toxonpf/aquaNode/AquaNode_R0.3/README_ru.md

# AquaNode R0.3

Ревизия по инженерному аудиту R0.2, 20 октября 2026. Исправлены механическое размещение, силовая трассировка, сшивка земли, EN стабилизатора, маркировка и представление схемы. Это проверенный комплект CAD для прототипа; физических испытаний ещё нет.

| Пункт аудита | Что сделано |
|---|---|
| Пространство под XIAO | C17/C18 перенесены правее J2; SMD убраны из контура модуля и зоны 4 мм ниже его торца. Контур показан на F.Fab; на F.SilkS — контур с разрывами у шелкографии колодок и USB-C END |
| Силовой узел | Q1/C7/L1/U7/D1/C8/C9/U8 сгруппированы; переключающий узел проложен короткими дорожками; локальный возврат GND 0,8 мм на нижнем слое |
| Ширина питания | Силовые линии 0,6 мм. Единственное сужение питания — 1,5 мм длины / 0,25 мм ширины непосредственно у U1.8 с шагом выводов 0,5 мм |
| Земля | 71 сквозное GND via 0,6/0,3 мм, приоритетные переходы у компонентов и распределённая сшивка двух заливок |
| EN U8 | Вывод 3 подключён к BOOST_IN, вместе с EN U7 |
| Два AFE | Таблица сборок A: 49,9k/49,9k; B: 10k/DNP. Текущий CAD показывает A |
| Импеданс ADS1115 | Расчёт остаточной ошибки и RC, задержка батарейного измерения 600 мс; утверждение о полном подавлении ошибки не делается |
| Подписи | Полярность и назначение контактов разъёмов, маркер K, ориентация XIAO и предупреждение B2B |
| Схема | Стандартные символы KiCad R/C/L/Schottky/PMOS/NMOS; пять функциональных областей |

Открывать `cad/AquaNode.kicad_pro`. Быстрый просмотр: `Report.html`, `Schematic.pdf`, `PCB.png` (оба слоя), `PCB_F.png`, `PCB_B.png`, `Assembly.png`. Нижний слой изображён в координатах вида сверху, без зеркального отражения. Контакты и монтаж сверять по `BOM_ru.md`, `Netlist_ru.md` и `Engineering_ru.md`.

**SKU 102010611: Wio-SX1262 стыкуется с XIAO ESP32S3 только через штатный B2B. Запрещено соединять сквозной пайкой левый ряд Wio с D0–D5 XIAO.** Проверить фактическую ревизию, высоту колодок, вывод BAT-проводов и доступ USB. Печатный контур не заменяет примерку купленных модулей.

Сырые ERC/DRC и геометрическая сверка — `checks/`. Gerber и Excellon — `fabrication_review/`. Проверки САПР не подтверждают пульсации питания, точность pH, работоспособность mesh или герметичность. Перед эксплуатацией выполнить протоколы `Purchase_and_test_ru.md`; для батарейного канала действует уточнённая задержка из `Analog_calculations_ru.md`.

Требования MIT и инструменты журналирования сохранены. Ничего не куплено и не измерено; стадия физического Prototype по-прежнему не подтверждена. Нативный Altium-проект не создавался; предоставлен редактируемый KiCad-проект.
