toxonpf/aquaNode/AquaNode_R0.3_EC_revB/engineering/Audit_ru.md

# Аудит и инженерные решения
## Что найдено и исправлено
1. Номинальные 3,3 В совпадали с нижней границей SEN0244. Даже отрицательный допуск 1% дал бы 3,267 В, без учёта провода и просадки. Перенесено питание M1 на существующие 5V_PH/TP5; J7.2 исключён из кабеля, медь 3V3 не изменена. Схема и design.json описывают тот же жгут.
2. C19 был перед R4, а рекомендация Espressif относится к конденсатору непосредственно у ADC. Перенесён на EC_ADC. С R21+R4 номинальное RC ≈110 мкс и частота среза ≈1,45 кГц, без учёта выходного сопротивления SEN0244. Это не фильтр медленных температурных ошибок и не доказательство точности.
3. PCB сохраняла DS18B20/DQ возле J7. Заменено на EC IN/EC; ревизия обновлена. Маркировка 3V3 возле J7.2 сохранена, поскольку медь остаётся 3V3. Сборщик обязан удалить именно кабельный контакт.
4. Старые BOM, netlist-документ, README, PDF, HTML и верификация противоречили новой сборке. Перенесены в history_ec_revA; текущие инструкции заменены. Полный BOM генерируется из design.json.
5. PH_EN=0 в прежнем скетче несовместим с новым источником EC. Теперь общий узел включается GPIO2 HIGH после настройки GPIO. J9 при EC-тестах отключён целиком. Включение питания pH не означает, что реализовано измерение pH.
6. Добавлены запрет сборки для неподходящего MCU/без USB CDC, повторный поиск DS18B20 после ошибки, флаг допуска питания и ограничение выдачи EC при непроверенной температурной компенсации. По умолчанию численное EC не выдаётся.
7. Идентификатор калибровки ограничен безопасными символами при генерации; значения из синтетических тестов не попадают в calibration.h.

## Питание: расчёт, не испытание
SEN0244: питание 3,3–5,5 В, выход 0–2,3 В, ток 3–6 мА. TPS7A2050 при применимости паспортных условий: 5 В ±1,5%, то есть 4,925–5,075 В. Статический запас до нижней границы SEN0244 — 1,625 В, до верхней — 0,425 В. Результат требует измерения выбросов/просадки и запуска, а не только мультиметра.

U7: R7=69,8 кОм, R8=20 кОм, оба 0,1%; Vref 1,208–1,258 В. Идеальный диапазон задания BOOST_RAW от ≈5,415 до ≈5,657 В. Это не полная граница: FB bias, load regulation, пульсации, запуск и монтаж добавляют ошибку. Рабочий вход U8 максимум 6,0 В: отсутствие выбросов выше него — блокирующая проверка. Нельзя принимать 400 мА ограничения ключа TPS61040 за доступный выходной ток 5 В. Питание всего узла идёт через XIAO 3V3, его свободный ток ещё не установлен.

SEN0244 при 5 В потребляет по паспортному току 15–30 мВт; это 0,36–0,72 Вт·ч/сутки на выходе 5 В при непрерывном питании. При условном совокупном КПД 80% — 0,45–0,90 Вт·ч/сутки от источника, без MCU и радио. Это иллюстрация, не измеренный бюджет автономности. Стенд не использует deep sleep. Экономию циклическим питанием можно заявить только после определения времени стабилизации.

## ADC и бюджет
DFRobot рекомендует ADS1115 для ESP32 (FAQ Q5). Встроенный ESP32-S3 ADC оставлен только для квалификационного стенда: он не требует нового компонента, диапазон 11 dB охватывает выход SEN0244, analogReadMilliVolts применяет калибровку напряжения, медиана подавляет часть помех. Это не доказательство достаточной линейности.

Предпочтительный путь следующей PCB при провале ADC-теста — использовать уже имеющийся ADS1115, освободив AIN2 от GND и выполнив новую трассировку/проверки. Дополнительная микросхема тогда не нужна, но требуется новая плата и прошивка. В этой ревизии такого изменения НЕТ. Паять EC к существующему AIN2/AIN3 нельзя. Второй модуль ADC добавляет стоимость без необходимости до результатов сравнительного теста.

## Открытые блокеры
| ID | Проблема | Условие закрытия |
|---|---|---|
| B01 | Нет native ERC/DRC revB, экспорта схемы и CAM-проверки | Запустить KiCad, разобрать все ошибки, экспортировать заново |
| B02 | ESP32 прошивка не скомпилирована | Успешная сборка реальным ESP32 toolchain, затем загрузка и USB-тест |
| B03 | Питание и shutdown transients | Осциллограммы по плану, без выхода за паспортные пределы |
| B04 | EC/ADC, температурная модель | Независимые стандарты, sweep напряжения, температурные точки |
| B05 | Взаимовлияние EC/pH | Сравнение раздельно/вместе; изоляция или документированный иной метод при провале |
| B06 | pH AFE не закреплён конкретным проверенным MPN | Подтвердить питание, выход, ток, прогрев; выбрать сборку делителя |
| B07 | Механика, герметичность, обрастание | Посадка XIAO/Wio, внешняя сборка и реальные водные испытания |
| B08 | Радио/mesh, частоты и регион | Отдельная прошивка, полевой тест, проверка местных требований перед TX |
| B09 | Батарея и зарядка | Конкретная защищённая 1S батарея, полярность, допустимые токи/температуры |

Старые документы ссылались на тайваньский радиоплан. Он не является настройкой для Казахстана или Гавайев. revB ничего не передаёт; конкретные радиопараметры не утверждены.

Полный просмотр состава включает декодирование файлов, структуры CAD/JSON, чтение текстовых материалов и PDF. Это не функциональная верификация каждой цепи или полная проверка всех footprint по даташитам. Список входных файлов и хешей — checks/input_inventory.json. Исходные лицензии и атрибуция сохранены.
