toxonpf/aquaNode/public/resources/ec-ph-revc/copy_zh-TW.md

# AquaNode R0.3-EC-pH-revC

## 文件範圍

本文件僅適用於 2026 年 11 月 2 日開發中的 R0.3-EC-pH-revC 測試台版本。團隊表示 AquaNode 已有裝置、經檢查感測器的量測與寄送給夥伴的浮標。這些裝置紀錄與下列 revC 檢查分開。

版本日期：2026 年 11 月 2 日。淡水環境教育平台配置；硬體驗證尚待完成。

## 目前配置

- XIAO ESP32S3 協調平台原始碼與 USB 記錄。
- SEN0244 是研究中的 TDS 模組，用於淡水實驗性 EC 估算；它不能辨識個別鹽類，也非海水鹽度儀。
- DS18B20 提供溫度輸入。
- SEN0169-V2 加入 pH 電極與轉換板。DFR0504 在 ADS1115 擷取前隔離其電源與類比訊號。
- pH 隔離器需要獨立穩壓平台電源：5.00 ±0.10 V、至少 0.5 A。電池供電 pH 仍需選定獨立轉換器並更新能耗預算。

## 校正與共同運作

此設計允許 pH 電極與 EC 留在同一水樣。隔離不證明干擾已消除。必須以真實緩衝液校正完整的電極–轉換板–隔離器–分壓器–ADC 鏈路，驗證電源，並分別與共同測試感測器。

原始碼讀取分壓器之後的 pH ADC 電壓。在真實校正與驗證放行之前，數值 pH 預設為 null；目前未提供真實 pH 或 EC 係數。數值 pH 限於已量測的校正範圍及校正溫度 ±0.5 °C，未宣稱自動 pH 溫度補償。手動放行旗標不是即時保護機制。

## 佐證與後續工作

套件報告記錄 18 項 Python 測試通過：15 項 EC 模型與 3 項 pH 匯出器測試。原始檔比對涵蓋 166 個原理圖接腳與 139 個編號 PCB 焊墊；銅箔及焊墊位置沿用 revB。這些檢查不驗證實體接線、感測準確度或 KiCad 設計規則。

ESP32 建置在下載相依套件時中斷。另有 15 項 C++ pH 斷言已準備但未執行。原生 ERC/DRC、裝置執行、真實校正、同一水樣測試、外殼與電池驗證仍待完成。目前沒有新的製造發行、revC 實測準確度、已驗證的無線電／網狀網路或實地部署佐證。

簡報設定檔明確標示為 simulation，範例讀值是虛構的；它與工程結果分開，硬體韌體不載入此設定檔。網站的台灣站點檔案是獨立來源，並非 AquaNode 量測。

公開網頁資料包含概覽、衍生狀態快照、佐證筆記與架構示意；不取代完整工程說明，也不公開韌體或協定實作。文件與網站衍生圖採 CC BY 4.0，保留原始出處。
