toxonpf/aquaNode/AquaNode_R0.3_EC_revB/history_ec_revA/Report.html

# AquaNode R0.3-EC

Бюджетная экспериментальная оценка проводимости пресной воды. Основа R0.3; SHT40 отсутствует.

R3 снять. J7 теперь EC. DS18B20 перенесён на D6/GPIO43. Старые прошивка и маркировка разъёма несовместимы с новой сборкой.

- Сборочная схема PDF · KiCad
- Подключение и ограничения
- Стоимость добавления
- Калибровка и приёмка
- Стендовый код
- Проверки

Проверенная цена SEN0244 $11.80. Ориентир электроники канала $13.80–16.80; стандарты, доставка и сборка отдельно. EC является оценкой, не паспортным измерением. Морская вода не поддерживается.

Новый ERC/DRC, компиляция ESP32 и физические испытания ещё не выполнены. Материалы исходного носителя — в baseline_r03.
