toxonpf/aquaNode/AquaNode_R0.3_EC_pH_revC/README_ru.md

# AquaNode R0.3 EC + pH revC

Обновлено 02.11.2026 по запросу: включить pH, выбрать конкретный комплект и повторно сверить подключения. В revC pH-электрод остаётся подключённым и может находиться в той же воде, что EC, через добавленную гальваническую развязку. Совместные измерения требуют стендовой приёмки.

Выбран **DFRobot SEN0169-V2**, комплект промышленного pH-электрода и платы преобразования с BNC. Между ним и AquaNode добавлен **DFRobot DFR0504**: развязка питания и аналогового сигнала. Температура — DS18B20, экспериментальная оценка EC — SEN0244, контроллер — XIAO ESP32S3, pH считывает установленный ADS1115.

**Это обновлённая стендовая конфигурация. Автономная работа pH от аккумулятора не завершена:** для DFR0504 используется внешний лабораторный источник 5,00 ±0,10 В, не менее 0,5 А. Ранее существовавший boost/LDO питает только EC; его токовый запас не подтверждён для добавленной нагрузки. Для батарейного буя нужен отдельный выбор и проверка преобразователя и обновлённый энергобюджет.

## Что изменено

- В KiCad-схему и `design.json` добавлены SEN0169-V2, DFR0504 и источник стендового питания.
- Обновлены BOM, подключения и пометки на плате. Геометрия меди и расположение площадок несущей платы сохранены.
- J9 подключён к стороне **MCU** DFR0504: контакт 1 — общая земля, контакт 3 — выход A. Контакт 2 исключён из кабеля. Перемычка JP1 снята.
- pH-модуль подключён только к изолированной стороне **SEN** DFR0504; её землю не соединять с землёй AquaNode.
- Прошивка `firmware/ec_ph_bench` считывает AIN0 ADS1115 по I²C GPIO5/GPIO6, адрес 0x48, и выдаёт `ph_adc_mv`, `ph`, `ph_status` через USB вместе с EC и температурой.
- Показания в милливольтах доступны сразу после начальной паузы; численное pH требует реальной калибровки всей цепи, проверки питания и совместной работы датчиков. Заводские или вымышленные коэффициенты не подставлены.

## Что читать

1. `engineering/Connection_review_ru.md` — выбор модели, результаты сверки и ограничения.
2. `engineering/Pinout_ru.md` — точная таблица сборки; актуальна вместо revB.
3. `bench/Plan_ru.md` — питание, калибровка и испытания обоих электродов в одной воде.
4. `firmware/README_ru.md` — сборка и формат данных.
5. `checks/` — фактические отчёты проверок этой поставки.

Исходный revB сохранён целиком в `history/original_revB.zip`. Его инструкции об отключении pH относятся к старой конфигурации. Старые Gerber/PDF внутри исторического ZIP не являются производственными файлами revC.

Новые Gerber не выпущены. Без native ERC/DRC, аппаратной проверки питания и испытаний в воде этот пакет не считать готовым к производству или подтверждением точности всего устройства.
