toxonpf/aquaNode/AquaNode_R0.3_EC_revB/history_ec_revA/MIT_requirements_ru.md

> **R0.3-EC, 29.10.2026:** исходный текст R0.3 ниже является базовой документацией. Для текущей сборки приоритет имеют EC_integration_ru.md и EC_BOM_ru.md: R3 отсутствует; J7 используется для EC; DS18B20 перенесён на D6/GPIO43. Старые ERC/DRC и Gerber находятся в baseline_r03 и не подтверждают новую сборку.

# Соответствие требованиям и доказательства

Статус на 20 октября 2026: по сообщению владельца ничего не куплено. Есть проект электроники, но нет физического прототипа, прошивки и результатов измерений. Нельзя выбирать стадию Prototype только на основании CAD-файлов.

Документ пользователя использован как план подготовки. Его рекомендации не превращены в обязательные правила MIT. Упоминание ESP8266/мутности в нём не заменяет исходное ТЗ: здесь ESP32S3, температура, pH и батарея; датчиков мутности и кислорода нет.

| Требование / рекомендация | Что подготовлено | Что ещё необходимо | Доказательство |
|---|---|---|---|
| Функционирующая первоначальная версия — критерий стадии Prototype | Трассированная плата, BOM, проверки CAD | Купить, собрать, написать и проверить прошивку | Непрерывное видео работающей цепочки |
| Реальные параметры воды | DS18B20 и вход pH AFE предусмотрены | Калибровка и сравнение с эталоном | Исходные коды АЦП, температуры, условия, коэффициенты |
| Передача и сохранение | Интерфейс SX1262, формат журналов и инструменты записи | Реализовать связь, собрать передатчик и приёмник | Два независимых журнала TX/RX с идентификаторами |
| Mesh, если заявляется | Распиновка не препятствует реализации | Третий узел, маршрутизация, проверка ретрансляции | Приём при заблокированном прямом пути, маршрут и TTL |
| Работа в воде — сильное подтверждение | Протокол подготовлен | Корпус, гермовводы, поплавок, испытания | Фото, время, масса до/после, состояние внутри |
| Повторяемость и автономность | Методика и формула энергобюджета | Измерить режимы и длительность работы | Осциллограммы/журнал тока, полный профиль, отказы |
| Стоимость и воспроизводимость | MPN носителя и перечень покупок | Фактические цены, доставка, ревизии | Чеки/счета, итоговая BOM собранного экземпляра |
| Климатическая польза | Проверяемая гипотеза ниже | Подтвердить проблему и действия оператора | Интервью, пилот, заранее выбранная метрика |
| Внешнее признание/YIC | Ничего не подтверждено | Только реальные документы при наличии | Публичная ссылка или документ организатора |

Количество пакетов, длительность теста и пороги точности ниже — внутренние цели разработки, а не требования MIT. Пример «97 из 100» из приложенного документа не является результатом AquaNode и не включён в доказательства.

## Практический маршрут

Сначала собрать два модульных узла на столе: один измеряет температуру, второй сохраняет принятые данные через USB на ноутбук. Собственная PCB не обязательна для этого первого доказательства. После устойчивой связи добавить pH, затем корпус и короткий водный тест. Заявлять ровно то, что удалось воспроизвести: один радиоканал не называть mesh, краткий тест не называть многомесячной автономностью.

Если до подачи нет работающего экземпляра, электронный проект остаётся стадией концепции. Обещание будущей сборки не заменяет выполнение критерия Prototype. Эта ревизия повышает готовность к сборке, но сама по себе не закрывает условия участия.

## Проверяемая гипотеза пользы

Рабочая гипотеза: оператор рыбоводного хозяйства использует сообщения о температуре и pH, чтобы вовремя проверить водоём и принять заранее согласованное действие. Для пилота нужно назвать конкретного оператора, сравнить время обнаружения отклонений с ручными обходами и фиксировать последующие действия. Снижение потерь рыбы, расхода энергии или выбросов пока не измерено. Температура и pH не измеряют растворённый кислород; не делать выводов о его концентрации и не запускать автоматическое управление аэрацией только по этим двум показателям.

## Комплект доказательств после испытаний

Хранить вместе: идентификатор экземпляра и ревизии; фото соединений; версии прошивки; исходные TX/RX журналы; калибровку и эталон; условия/место/дату; видео; таблицу отказов; фактическую BOM; краткий отчёт с ограничениями. Не редактировать исходные журналы для удаления неудачных измерений — помечать исключения отдельно. Публиковать только данные с разрешением владельца площадки.

В разделе заявки о сделанном описывать только завершённые работы; план выделять отдельно. Сейчас допустимая формулировка: «Разработана и проверена средствами KiCad схема и трассировка носителя. Закупка, прошивка и физические испытания ещё не выполнены». После теста заменить её фактическими числами с условиями и ссылками, не заранее заполненным успехом.

## Официальные источники и сроки

[MIT Solve Global Climate Challenge](https://solve.mit.edu/challenges/2027-global-climate-challenge?tab=faq) описывает стадии и критерии. [Официальная анкета 2027](https://5593819.fs1.hubspotusercontent-na1.net/hubfs/5593819/2027%20Global%20Challenges_%20Application%20Questions.pdf) просит объяснить выбранную стадию и уже выполненные работы. На проверенной странице указан срок 6 ноября 2026, 12:00 EST; в PDF анкеты — 2 ноября. Для внутренней подготовки использовать более раннюю дату, окончательный срок сверить в действующем портале перед подачей. Наличие всех рекомендуемых доказательств не гарантирует отбор.

## Как описывать EC в заявке

«Разработана бюджетная экспериментальная интеграция проводимости для пресной воды; аппаратная калибровка и полевые испытания запланированы». После испытаний заменить фактическими цифрами. Не писать о морской солёности, лабораторной точности или работающем канале только на основании CAD и программных тестов.
