toxonpf/aquaNode/docs/editorial-audit-2026-11-04.md

# Редактура AquaNode — 4 ноября 2026

Основание: задание владельца от 3 ноября и уточнение 4 ноября: разрешены расчётные примеры на основе региональных измерений с отклонением до 5%. Работа выполнена в исходниках, без публикации сайта.

## Что изменено

- Главная: факты об измерениях и отправке устройств, прямые ссылки на карту и устройство. Удалены общая плашка revC, повторный рассказ о трёх частях буя, декоративный переход «почему вода», пять абзацев учебного цикла, повторные заголовки документации и команды.
- О проекте: три учебных действия «Собрать / Измерить / Обсудить результаты». Удалены общая плашка ревизии, неподтверждённые цели 10 / 500+ / 50+ км, повторная миссия и слоганы. Сохранены сертификат YIC 2026 и GEEP.
- Устройство: существующие устройства описаны перед отдельной revC. Сохранены SEN0244, DS18B20, SEN0169-V2, DFR0504, ADS1115, отдельное питание pH и температурное ограничение. Проверки кода не переименованы в аппаратные испытания. Компоновка 3D остаётся иллюстративной.
- Build: выбор актуальных обзорных документов revC либо архивных материалов платы R0.3. Сохранены семь раскрывающихся задач разработки и якоря; удалены повторные «перед следующим шагом» и описание самого интерфейса. Файлы не называются полным комплектом изготовления или прошивкой.
- Журнал: удалены декоративная обложка и повторные объяснения чтения. Добавлена недатированная заметка команды об устройствах и сотрудничестве. Датированные проверки revC от 2 ноября и R0.3 от 20 октября сохранены; исходные результаты не изменены.
- Команда: сохранены имена, роли и контакты, удалены повторные общие биографии и слоганы. Для сотрудничества используется уже опубликованный Telegram основателя.
- Метаданные: отдельные title / description / OG для всех семи маршрутов, начальный HTML согласован с русской главной.
- RU / EN / zh-TW: новые тексты и доступные подписи сведены в `editorial-ru.json` / `editorial-zh.json`; английский остаётся источником строк. Обзоры revC и генератор схем также уточняют область применения.

## Привязка фактов к источникам

| Объект | Что известно | Что показано |
| --- | --- | --- |
| Существующие AquaNode | Владелец подтвердил устройства, проверку датчиков, данные и отправку партнёрам | Сообщение команды; без выдуманных ID, дат, точности и количества |
| География сотрудничества | Актау, Гавайи, Тайвань из задания и прежних материалов | Три региональные отметки. Это не три устройства и не установленная сеть |
| revC | Пакет 2 ноября 2026, состав и отчёты в `AquaNode_R0.3_EC_pH_revC` | Собственная конфигурация и статус разработки |
| R0.3 | Прежняя плата, отчёт 20 октября, чертёж / BOM | Отдельный архив документов и запись журнала |
| Станции Тайваня | `stations_data_en.csv`, 388 записей, четыре станции, 2002–2026 | Исходные даты, числовые значения, пропуски и пределы обнаружения; CSV для скачивания |
| Расчётные примеры | Получены программно из выбранной записи станции | Привязаны к 104 исходным отметкам; источники — региональные публикации и архив станций. Исходное и расчётное значения, отклонение до 5% видны рядом |

## Карта и данные

После уточнения владельца восстановлены все 104 исходные отметки (97 Актау, 3 Гавайи, 4 Тайвань), с прежними ID и позициями. Счётчик обозначает отметки карты; координаты остаются приблизительными. Четыре референсные станции сохранены отдельным отключаемым слоем.

Каждому бую назначены явно подписанные расчётные показания, полученные из опубликованных региональных наблюдений с отклонением не более 5%. Для Актау используется pH 8.12 из пробы K4 от 13.09.2023; для Гавайев — региональные средние у Мауи (26.3 °C, pH 8.17), с явной оговоркой о географии; для Тайваня — соответствующая запись станции из CSV. Даты и пропуски источника сохранены. Все 104 записи доступны в JSON с признаком `calculation-example`. Метод, ссылки и ограничения описаны в [observation-map.md](observation-map.md).

## Что ещё нужно от команды

- Исходные измерения самих буёв AquaNode: устройство/версия, параметр и единица, время с часовым поясом, место, файл или API.
- Подтверждённый список устройств и дат отправки / доставки / установки. Общий факт отправки не использован как доказательство установки или текущей передачи.
- Состав фактически проверенных сборок и записи их калибровки. Состав revC не перенесён на эти устройства.
- Публичные имена партнёров и разрешённые сведения о сотрудничестве, если требуется назвать организации.

Поэтому реальные измерения **AquaNode** не опубликованы как числовые карточки: их файлов не предоставили. Публикуются реальные записи **сторонних станций** и отдельно отмеченные расчётные примеры. Пустые измерительные шаблоны из инженерного пакета не использованы как результаты.

## Проверка

Выполнены целевые браузерные проверки всех семи маршрутов на RU / EN / zh-TW при 1440, 390 и 320 px (63 сочетания), а также проверки оборудования и документации на дополнительных размерах 768–1920 px.

41 целевой тест прошёл в соответствующих группах Playwright: `pages/editorial`, `pages/about`, `pages/build`, `pages/journal`, `pages/map`, `pages/technology`, `pages/revc-content`, `pages/home-features`, `ui/content-integrity`, `ui/map-embeds-mobile`, `team/team-flow`. Проверены метаданные, якоря, раскрытие, управление с клавиатуры, датчики, оригинальные даты и пропуски CSV, граница 5%, загрузки и неизменность статуса revC. Тесты выполнялись с `PLAYWRIGHT_CHROMIUM_EXECUTABLE_PATH=/usr/bin/chromium`; проверка карты также включает недоступность внешней подложки.

`npm run build` и `git diff --check` проходят. Просмотрены снимки компьютера и телефона, включая RU / zh-TW и расчётную карточку EN / RU. Это целевой набор для редактуры, не полный исторический набор всех UI-тестов репозитория. Физические испытания этой редактурой не выполнялись.

## Уточнения дизайна и восстановление карты

После обратной связи владельца:

- Разнесены кнопки в океанском блоке «Что такое AquaNode». Удалены градиентные маски, затемнявшие верхние подписи четырёх глав.
- Большие пустые завершения страниц заменены компактными парными переходами. Контактный блок команды также уплотнён, без изменения геометрии профилей.
- Дополнены заголовок результатов и блок `#why` на главной; добавлена последовательность из трёх этапов наблюдения.
- В первый экран журнала добавлены последние записи с рабочими якорями и фактическими метриками проверок.
- Блок существующих устройств дополнен архивной схемой с подписью версии и перечнем результатов команды; intro оборудования Build оформлен как подготовка рабочего места.
- Восстановлены 104 исходных маркера с прежними ID и позициями, добавлены расчётные записи и JSON-выгрузка. Метод и источники — в `observation-map.md`.

Итоговые целевые проверки охватывают 40 различных тестов Playwright: `editorial`, `layout-restoration`, `map`, `map-embeds-mobile`, `about`, `build`, `home-features`, `journal`, `technology`, `content-integrity`, `team-flow`. Проверены три языка, ширины 320–1920 px, раскрытия и якоря, отсутствие переполнения, геометрия карточек команды, исходные даты/пропуски и предел генерации 5%. Найденная мелкая подпись схемы исправлена; повторная проверка минимальных размеров прошла. Просмотрены скриншоты новых блоков, океанских подписей и карточек данных. Финальные `npm run build` и `git diff --check` проходят.
