toxonpf/aquaNode/docs/team-contacts.md

# Фотографии и контакты команды

Данные находятся в `src/data/catalog.ts`, массив `team`. Разметка страницы — в `src/pages/team/TeamRoster.tsx`. Карточка, модальный портрет и миниатюра используют единый компонент `src/pages/team/TeamPortrait.tsx`: одинаковые фото, тонировку, волны, подпись и инициалы.

Участники показаны в портретной галерее. Нажатие на портрет открывает профиль с крупной фотографией и теми же контактами. Внутри профиля доступны переключение участников, закрытие кнопкой и Escape. На телефоне все ссылки видны без наведения.

Колонки галереи имеют независимый вертикальный ритм: следующий портрет начинается до окончания предыдущего. На телефоне продолжение дополнительно обозначено миниатюрой следующего участника. При прокрутке портреты раскрываются диагональной шторкой. При открытии профиля изображение сначала останавливается в центре экрана, затем сдвигается вместе с раскрытием панели информации. При переключении людей панель убирается, портрет возвращается в центр, сменяется следующим и снова раскрывается. Карточки в галерее плавно меняют прозрачность; выбранная остаётся скрытой до завершения возврата изображения при закрытии окна. Настройка уменьшения движения отключает эти анимации.

Первыми показаны Timur Kuandykov и Roman Benzler. Для Кирилла подключены Telegram, GitHub и LinkedIn; для Романа и Тимура — LinkedIn и Telegram; для Аяна — Instagram, Spotify, LinkedIn и Telegram. Адреса предоставлены командой. У Артура контакты пока не заполнены. Значение `url: null` остаётся поддержанным вариантом некликабельной заготовки.

Чтобы подключить несколько контактов одному человеку, замените его запись, например так (адреса ниже демонстрационные, их нужно заменить):

```ts
{
  slug: 'kirill-dubinin',
  name: 'Kirill Dubinin',
  role: 'Engineering & outreach',
  photo: '/assets/team/kirill-dubinin-portrait.webp',
  links: [
    {kind: 'email', label: 'Email', url: 'mailto:your-address@example.com'},
    {kind: 'telegram', label: 'Telegram', url: 'https://t.me/YOUR_HANDLE'},
    {kind: 'github', label: 'GitHub', url: 'https://github.com/YOUR_HANDLE'},
    {kind: 'website', label: 'Website', url: 'https://example.com'},
  ],
}
```

Можно добавить любое количество элементов в `links`. Для двух контактов одного вида задайте разные `label`, например «Рабочая почта» и «Личная почта». Поддерживаются `email`, `telegram`, `github`, `website`, `linkedin`, `instagram`, `spotify`. Внешние веб-ссылки открываются в новой вкладке; `mailto:` и `tel:` обрабатываются браузером обычным образом.

Фотографии положите в `public/assets/team/` в формате WebP. Поле `profilePhoto` задаёт фотографию внутри раскрытого профиля; поле `photo` — в карточке галереи и миниатюрах. Для Тимура, Романа и Аяна подключены оба поля: используются ранее присланные фотографии, с волнами поверх карточек. Имена файлов имеют вид `имя-фамилия-portrait.webp`. Исходные JPEG/PNG хранятся в `assets-source/team/` и не попадают в сайт. Значение `null` оставляет графический портрет с инициалами.

Сертификат GEEP размещён в `public/resources/awards/geep-yic-2026-winner.png`, его оптимизированное превью — в `public/assets/awards/geep-yic-2026-winner.webp`. Пути находятся в `awardCertificate` в каталоге контента. Сценарий `scripts/prepare-site-images.mjs` локально преобразует исходные изображения и переносит их из корня; существующие файлы не перезаписывает.
