toxonpf/aquaNode/AquaNode_R0.3_EC_pH_revC/bench/Plan_ru.md

# Стендовая приёмка revC: pH + EC + температура

Это план, результаты ещё не получены. Численные цели ниже — критерии для испытаний, а не достигнутые характеристики. Сохранять дату, исполнителя, прибор/погрешность, фото жгута, SHA256 прошивки и калибровки, сырой USB-лог и pass/fail. Независимый контрольный раствор не использовать для подбора коэффициентов.

## 1. До подачи питания

Проверить `engineering/Pinout_ru.md` по каждому соединению. R3 отсутствует; J7.2 и J9.2 без кабельных контактов; JP1 открыт; C19 после R4. Плата SEN0169-V2 соединена только с SEN стороной DFR0504. Основная земля и изолированная земля не соединены через крепёж, кабель, термощуп или приборы. Вода будет связывать электроды электрохимически, поэтому проверку отсутствия металлического обхода проводить до погружения. Проверить полярность батареи, механическую посадку XIAO/Wio и отсутствие чужих перемычек.

Native KiCad ERC/DRC должны быть выполнены и разобраны до изготовления PCB. Исходниковая сверка в пакете их не заменяет. Первый запуск допускается на отдельно проверенном макете с ограничением тока, не как подтверждение исходной PCB.

## 2. Питание

Проверить EC узел без SEN0244 с нагрузкой 1 кОм, затем 820 Ом. Проверить 5V_PH и BOOST_RAW при USB и выбранных режимах батареи. Установившееся 5V_PH — целевые 4,85–5,15 В; питание SEN0244 при работе в паспортных пределах 3,3–5,5 В, BOOST_RAW не выше рабочего максимума U8 6,0 В, включая выбросы с учётом погрешности. Затем повторить с SEN0244, измерить ток и запуск.

Для M4 отдельный PS1: **5,00 ±0,10 В на входе MCU** под реальной нагрузкой, включая пуск и переходы. Проверить изолированный SEN выход 4,8–5,2 В, ток pH-модуля <170 мА с запасом и суммарный ток первичной стороны. Внешний источник ≥0,5 А выбран как стендовый запас, а не измеренное потребление. TP5 не использовать для питания M4.

Включать AquaNode первым, внешний PS1 последним; выключать в обратном порядке. Осциллографом проверить PH_OUT, ADC_PH, 3V3 и EC_ADC при включении/выключении, минимум 20 циклов. Во время работы входы ADC остаются между GND и VDD; при отключении не превышают абсолютные пределы из даташитов и не поддерживают выключенную 3V3 подпиткой. На изолированной стороне использовать дифференциальный/изолированный пробник; обычной землёй осциллографа нельзя закорачивать барьер. До автоматического полевого применения нужна аппаратная блокировка неверного порядка питания.

Только после этого выставлять `SUPPLY_VALIDATED` для EC и `PH_SUPPLY_VALIDATED` для pH. Это ручные отметки принятия конкретной сборки, а не динамическая защита.

## 3. ADC и температура

EC: отключить выход SEN0244, подать точные 0,15/0,25/0,5/1/1,5/2/2,3 В через R21/R4; ≥100 отсчётов на уровень. Предварительная цель ошибки: ≤max(10 мВ, 1%), разброс P90−P10 ≤10 мВ. Порог 40 мВ прошивки — только грубая отбраковка.

pH: сначала проверить ADS1115 AIN0 введением напряжений на PH_OUT через штатный делитель (изолятор A отсоединён). Затем отдельно проверить всю цепь M4 от SEN A до AIN0. Дать время на 4-секундное типичное обновление изолятора и фильтры; подтвердить реальное время установления. Сравнить с независимым вольтметром, проверить монотонность, коэффициент передачи и дрейф. Проверка AIN0 без изолятора не подтверждает весь канал.

DS18B20: проверить в точках 10/25/35 °C с эталонным термометром, отключение и восстановление. При отсутствии корректной температуры численное pH/EC не выдаётся. Не принимать 85 °C после старта или −127 °C ошибки за воду.

## 4. pH-калибровка всей цепи

Электрод подготовить по руководству производителя, держать плату и BNC сухими. Применить свежие буферы с известным pH при фактической температуре. Калибровать всю цепь: электрод → M3 → M4 → R9/R10 → ADS1115. Записывать **`ph_adc_mv` после делителя**, не напряжение электрода и не удвоенные милливольты. Значение pH буфера брать из его температурной таблицы.

Производитель использует pH 4 и 7. Для щелочной воды нужны точки, охватывающие ожидаемый диапазон, например 7 и 10, и независимая проверка внутри диапазона. Прошивка допускает две реальные точки с разницей ≥2 pH и убывающим напряжением; численное pH за пределами калибровки не экстраполирует. При необходимости широкого диапазона дополнительно оценить линейность по нескольким стандартам.

Для каждой точки дождаться устойчивости, сохранить ≥20 показаний, среднее/медиану и температуру. Создать JSON с `cal_id`, `adc_mv_low`, `ph_low`, `adc_mv_high`, `ph_high`, `temperature_c`; low/high относятся к **pH**, поэтому mv_low > mv_high. Генератор `test_tools/export_ph_calibration.py` создаёт заголовок, затем его надо поставить в прошивку и пересобрать. Не применять синтетические тестовые данные.

Пока температурная модель не исследована, pH выдаётся лишь в пределах **±0,5 °C от температуры калибровки**. Температурная поправка буферов и компенсация чувствительности электрода — разные задачи; автоматическая компенсация не заявляется.

Независимая проверка: предварительная цель всей цепи ≤0,2 pH в выбранном диапазоне при температуре калибровки. При провале раздельно проверить изолятор и AFE; ±0,1 pH из паспорта датчика не является гарантией AquaNode.

## 5. EC-калибровка и совместная работа

EC калибровать по `test_tools/ec_model.py` двумя стандартами и проверить третьим независимым. SEN0244 остаётся TDS-модулем с экспериментальной оценкой EC. Проверить нелинейность ADC и температурную поправку; без её допуска EC ограничен 25 ±0,5 °C. Сохранить старый EC-план из `history/original_revB.zip` только как справочный материал; старое требование убрать pH не относится к совместному тесту revC.

Сравнить в одном образце при неизменной температуре: pH отдельно; EC отдельно; оба подключены и включены; EC выключен; PS1 выключен при всё ещё включённом MCU. Удаление/добавление электрода тоже фиксировать, не менять одновременно состав воды. Повторить с разными проводимостями и расстоянием между пробами, минимум 3 повторения.

Предварительная цель влияния: изменение pH ≤0,05 и EC ≤max(20 мкСм/см, 2%). Если разброс методов не позволяет различить такой сдвиг, результат неопределённый, а не PASS. При провале выяснить обход изоляции, питание и помехи, затем повторить. **`PH_COEXISTENCE_VALIDATED=true` выставлять только после прохождения этого теста**. При замене датчика, источника, жгута или схемы снять допуски и повторить проверку.

## 6. После допуска

24-часовой лог с обоими электродами, контрольные растворы до/после, дрейф, перезапуски, энергопотребление. Затем испытания корпуса и обрастания в воде. Числа автономности выводить из измеренного энергопрофиля и выбранной батареи. Радио/mesh остаются отдельной задачей: текущая прошивка работает через USB.
