toxonpf/aquaNode/AquaNode_R0.3_EC_pH_revC/engineering/Budget_options_ru.md

# Почему добавление pH стоит $84,80

Цены проверены 02.11.2026 на страницах производителя, без доставки и налогов.

| Вариант | Комплектация | Сумма |
|---|---|---:|
| Выбранный для длительного мониторинга | SEN0169-V2 $64,90 + DFR0504 $19,90 | $84,80 |
| Учебный лабораторный макет с развязкой | SEN0161-V2 $39,50 + DFR0504 $19,90 | $59,40 |
| Отдельный лабораторный pH-канал | SEN0161-V2 без развязки; pH и EC измеряются в отдельных пробах | $39,50 |

Разница между двумя комплектами pH — $25,40. Приоритетом прежнего выбора было длительное погружение электрода; для коротких учебных опытов лабораторный комплект дешевле. Производитель предупреждает о дрейфе лабораторных электродов при продолжительных измерениях и рекомендует промышленную серию для длительного мониторинга.

Дешёвый вариант без развязки не является заменой текущей схемы совместного погружения. Простого выключения EC недостаточно, чтобы считать его электрически изолированным.

В этом обновлении модель в инженерной схеме не заменена: варианты приведены для выбора бюджета. Цена всего буя, автономного преобразователя и корпуса в суммы не входит.

Источники: [SEN0169-V2](https://www.dfrobot.com/product-2069.html), [SEN0161-V2](https://www.dfrobot.com/product-1782.html), [DFR0504](https://www.dfrobot.com/product-1621.html).
