toxonpf/aquaNode/AquaNode_R0.3_EC_pH_revC/engineering/Connection_review_ru.md

# Выбор pH и повторная сверка соединений

Дата: 02.11.2026. Ревизия: R0.3-EC-pH-revC.

## Выбранный комплект

**DFRobot SEN0169-V2** включает pH-электрод промышленного исполнения и плату преобразования V2. Производитель предусматривает непрерывный мониторинг, а лабораторный SEN0161-V2 предназначен для другого режима обслуживания. Для буя с погружённым электродом выбран SEN0169-V2. Это выбор по назначению и совместимости; сравнения экземпляров в воде ещё нет. [Карточка производителя](https://www.dfrobot.com/product-2069.html), [характеристики и распиновка](https://wiki.dfrobot.com/sen0169-v2/).

Паспорт платы: питание 3,3–5,5 В, аналоговый выход 0–3 В, BNC и трёхконтактный сигнальный разъём. Электрод: pH 0–14, температура 0–60 °C, кабель 5 м. Заявленная точность ±0,1 pH при 25 °C относится к комплекту производителя, а не ко всей добавленной цепи AquaNode. Требуются калибровка и обслуживание электрода.

**DFRobot DFR0504** установлен в канал pH, чтобы разорвать электрическую связь между ним и основным узлом с EC. Он изолирует одновременно питание и аналоговый сигнал. По данным производителя: вход питания 5,0 ±0,1 В, изолированное питание 5,0 ±0,2 В, ток холостого хода около 75 мА, выходной ток стороны SEN не более 170 мА, типичная задержка 4 с и типичная ошибка передачи до ±20 мВ. Изоляция снижает риск взаимного влияния, но результат определяется совместным испытанием. [Описание DFR0504](https://www.dfrobot.com/product-1621.html), [условия подключения](https://wiki.dfrobot.com/dfr0504/docs/19034).

На 02.11.2026 карточки производителя показывали $64,90 за SEN0169-V2 и $19,90 за DFR0504: добавление этих двух комплектов — **$84,80**. Не учтены доставка, налоги, растворы, стендовый источник, корпус и будущий преобразователь автономного питания. Цена всего буя по этим данным не определяется.

## Питание и диапазоны

Прежний TPS61040/TPS7A2050 не назначен источником питания DFR0504: доступный ток и нагрев этого узла не проверены. В revC DFR0504 получает 5 В от отдельного лабораторного источника ≥0,5 А. pH получает только изолированное питание стороны SEN; диапазон 4,8–5,2 В находится внутри допустимого питания pH-платы. Реальный ток pH-модуля и запас до предела 170 мА надо измерить.

DFR0504 сам потребляет около 0,375 Вт, или около 9 Вт·ч в сутки при непрерывном включении, ещё без датчика, контроллера и потерь источника. Поэтому прежние оценки автономности EC нельзя переносить на совместную сборку. Независимый батарейный преобразователь и его управление пока не выбраны.

DFR0504 допускает аналоговый выход до 5 В, хотя pH-плата выдаёт до 3 В. **R9/R10 49,9 кОм/49,9 кОм сохраняются**, так что штатный вход ADS1115 получает примерно половину напряжения. При проверочном выходе 5,1 В и худшем сочетании допуска резисторов 0,1% получается не более 2,553 В — ниже 3,3 В питания ADC. Это расчёт установившегося режима, не защита от произвольного перенапряжения или выключенного питания.

ADS1115 настроен на ±4,096 В, 16 SPS, single-shot, AIN0 относительно GND; шаг 0,125 мВ. PGA не разрешает превышать напряжение питания на аналоговом входе. Высокое сопротивление делителя может давать загрузочную ошибку ADC; необходима калибровка **всей цепи**, а не только pH-модуля. [TI ADS1115](https://www.ti.com/lit/ds/symlink/ads1115.pdf).

## Что сверено

Повторная программная проверка читает фактические координаты выводов символов и проводов KiCad, метки сетей, контакты PCB и `design.json`. Проверены **166 контактов схемы и 139 нумерованных площадок PCB**. Несоответствий между этими источниками не обнаружено. Сохранены отдельный JSON-отчёт и список выводов `checks/pin_by_pin.json`.

Проверены цепи pH от M3 через M4 к J9 и ADS1115, соответствие I²C GPIO5/6 и адресу 0x48, EC GPIO1, DS18B20 GPIO43, DNP R3, положение C19 после R4, питание и отключённые контакты кабеля. Изолированные сети pH в исходниках принадлежат только M3 и M4. Сегменты, переходы, зоны меди, площадки и расположение компонентов PCB совпадают с revB.

По официальной распиновке XIAO подтверждены D0/GPIO1, D1/GPIO2, D3/GPIO4, D4/GPIO5, D5/GPIO6, D6/GPIO43. У Wio используется штатное B2B, радиокод не добавлен. [Seeed XIAO](https://wiki.seeedstudio.com/xiao_esp32s3_getting_started/), [комплект Wio](https://wiki.seeedstudio.com/wio_sx1262_with_xiao_esp32s3_kit/).

## Исправления относительно revB

| Было | Стало |
|---|---|
| pH отключён, модель TBD | SEN0169-V2 подключён через DFR0504 |
| Прошивка не читала ADS1115 | AIN0 читается; добавлены pH-поля USB |
| JP1 и J9 описывали прямое питание AFE | JP1 открыт, J9.2 без контакта, pH питает изолятор |
| Не определено решение для pH/EC помех | Добавлена развязка; обязательный сравнительный тест сохранён |
| Старые отчёты и инструкции в активных папках | Исходная поставка сохранена в отдельном историческом ZIP |

## Что ещё нельзя подтвердить по файлам

- Фактическую прозвонку кабеля, полярность купленных модулей и отсутствие обхода изоляции через приборы/корпус.
- Аппаратную точность, пульсации, выбросы, подпитку при отключении и достаточность питания.
- Проверку всех унаследованных посадочных мест и полной электрической/геометрической корректности платы. Выполненная сверка исходников не заменяет native KiCad ERC/DRC, которые здесь не запускались.
- Герметичность, длительное нахождение в воде, обрастание и автономность.

Включённый pH-канал не означает, что можно выставить флаги калибровки без измерений. Цифровое pH до допуска остаётся `null`, а реальное напряжение AIN0 считывается. Снятие питания EC программой не является гальванической развязкой. Электрод без воды или неисправный электрод не всегда можно распознать по одному аналоговому напряжению.
