toxonpf/aquaNode/AquaNode_R0.3_EC_revB/bench/Run_record_blank.md

# Протокол — НЕ ЗАПОЛНЕН
Дата / исполнитель:
Серийный номер / версия платы / фото сборки:
Хеши design.json / firmware / calibration.h:
Источник питания / батарея / напряжение:
Приборы, серийные номера, сроки калибровки, неопределённость:
Растворы: производитель, партия, срок, EC25, температурная таблица:
Вода / температура / погружение / расстояние до стенок:
Критерий до начала испытания:
Исходные файлы:
Наблюдения и сбои:
Результат PASS / FAIL / INCONCLUSIVE:
Отклонения от плана:
Какие заявления теперь подтверждены и в каких пределах:
Подпись ответственного:
