toxonpf/aquaNode/AquaNode_R0.3_EC_revB/web_handoff/publishing_rules.md

# Правила публикации
Можно публиковать тексты copy_ru/copy_en, статус, факт наличия инженерных исходников и результаты программных тестов с прямой подписью «синтетические данные». Разрешён assets/architecture.svg с подписью «Схема проектируемой системы, не фото прототипа; аппаратные испытания предстоят». Диаграмма не электрическая схема.

Нельзя сейчас: «работающий автономный буй», «измеряет солёность», «точность ±X%», «сеть mesh работает», «несколько недель автономности», «испытан в океане», «пилот на Гавайях», «партнёр MIT», число пользователей, экономический или экологический эффект. Если владелец предоставит независимые подтверждения, их нужно связать с датой, версией устройства и пределами результата.

Не использовать файлы baseline_r03/ и history_ec_revA/ как текущие картинки. Не публиковать Connection_review.pdf как экспорт актуальной принципиальной схемы. После native экспорта и ревью можно отдельно добавить актуальную схему с лицензией и статусом.

Материалы сайта: CC BY 4.0 для новой документации и диаграммы с атрибуцией AquaNode; сохранять ссылку на исходный open-pisciculture и ATTRIBUTION.md при распространении производного пакета. Hardware CERN-OHL-P-2.0, software MIT; исходные сторонние лицензии неизменны. Имена компаний не означают поддержку проекта.

Чек-лист перед публикацией: ревизия и дата видны; ограничения рядом с функциями; пустые измерения не заменены демоданными; нет чужих фото; все доказательства доступны; факты из испытаний помечены отдельно от планов. Публикация не входит в выполненную работу.
