toxonpf/aquaNode/public/resources/ec-ph-revc/copy_ru.md

# AquaNode R0.3-EC-pH-revC

## Область документа

Документ относится только к разрабатываемой стендовой R0.3-EC-pH-revC от 2 ноября 2026 года. По сообщению команды, у AquaNode уже есть устройства, измерения с проверенных датчиков и отправленные партнёрам буи. Их записи отделены от проверок revC ниже.

Ревизия от 2 ноября 2026 года. Учебная пресноводная стендовая конфигурация; аппаратные испытания предстоят.

## Текущий состав

- XIAO ESP32S3 координирует стендовые исходники и USB-запись.
- SEN0244 — TDS-модуль, исследуемый для экспериментальной оценки EC в пресной воде. Он не определяет отдельные соли и не является прибором солёности морской воды.
- DS18B20 даёт температурный вход.
- SEN0169-V2 добавляет pH-электрод и плату преобразования. DFR0504 развязывает питание и аналоговый сигнал перед опросом ADS1115.
- Развязке pH нужен отдельный стабилизированный стендовый источник: 5,00 ±0,10 В, не менее 0,5 А. Для автономного pH ещё нужны выбор отдельного преобразователя и новый энергобюджет.

## Калибровка и совместная работа

pH-электрод в этом проекте может оставаться в той же воде, что EC. Развязка не доказывает отсутствие помех. Нужны реальные буферы для калибровки всей цепи электрод–плата–развязка–делитель–АЦП, проверка питания и сравнение датчиков отдельно и вместе.

Код считывает напряжение pH на АЦП после делителя. Численное pH по умолчанию null до реальной калибровки и приёмки. Реальные коэффициенты pH и EC отсутствуют. pH выдаётся только внутри измеренного диапазона и при температуре калибровки ±0,5 °C; автоматическая температурная компенсация pH не заявляется. Ручные флаги приёмки не являются динамической защитой.

## Проверки и предстоящая работа

В отчёте пакета пройдены 18 Python-тестов: 15 модели EC и 3 экспортера pH. По исходникам сверены 166 выводов схемы и 139 нумерованных площадок PCB. Медь и расположение площадок не изменены относительно revB. Эти проверки не подтверждают физический монтаж, точность или правила KiCad.

Попытка сборки ESP32 прервана загрузкой зависимости. Ещё 15 C++-проверок pH подготовлены, но не запущены. Штатные ERC/DRC, запуск на устройстве, калибровка, совместные испытания в воде, корпус и автономность ещё не проверены. Нового производственного выпуска, измеренной точности revC, подтверждённых радио/mesh или полевого размещения нет.

Презентационный профиль явно обозначен как simulation и содержит вымышленные примеры. Он отделён от инженерных результатов и не загружается аппаратной прошивкой. Архив станций Тайваня на сайте — независимый источник, не измерения AquaNode.

Публичные веб-материалы: обзор, производный снимок статуса, реестр проверок и иллюстрация архитектуры. Они не заменяют полных инженерных инструкций и не публикуют реализацию прошивки или протокола. Документация и производные схемы сайта: CC BY 4.0 с сохранением исходной атрибуции.
