toxonpf/aquaNode/public/resources/ec-revb/ATTRIBUTION.md

# AquaNode R0.3-EC-revB — web materials

Revision: 29 October 2026.

New documentation and architecture diagram: AquaNode, CC BY 4.0 (https://creativecommons.org/licenses/by/4.0/). The diagram is a design overview, not a prototype photograph or an electrical schematic. Hardware validation is pending.

The project builds on open-pisciculture: https://github.com/open-pisciculture/open-source-fish-farming-prototypes

Original source attribution and licences remain available in [the earlier attribution record](/resources/ATTRIBUTION.md). Hardware: CERN-OHL-P-2.0; software: MIT. Third-party licences remain unchanged. Company and institution names do not imply support for AquaNode. These web downloads do not contain the engineering package, firmware or protocol implementation.

Localized architecture illustrations (English, Russian and Traditional Chinese for Taiwan, including mobile compositions) were redrawn for the website from the supplied design overview. They remain design illustrations, not prototype photographs or native electrical schematics. The original handoff diagram is preserved at `/assets/engineering/ec-revb-architecture.svg`. The derived illustrations retain CC BY 4.0 attribution.
