toxonpf/aquaNode/public/resources/ec-revb/copy_zh-TW.md

# AquaNode
## 透過親手組裝浮標，探索淡水環境

AquaNode 致力開發可負擔的淡水環境教育浮標。我們希望學生能組裝硬體、運用感測讀值，並學習檢驗自己對環境的結論。

## 目前階段：工程開發

我們已準備可編輯的電路圖與 PCB 檔案、零件清單、平台韌體原始碼及測試計畫。目前版本研究以 SEN0244 模組進行低成本導電度估算，搭配 DS18B20 溫度感測。修訂後的供電與接線設計，仍需於測試平台驗證。

## 已記錄的進展

- 已修訂實驗性 EC 通道與溫度感測器連接的設計檔。
- 已準備 USB 資料擷取與校正模型的原始碼。
- 以合成輸入檢查軟體。這些檢查不能證明感測器準確度或硬體運作。
- 已規劃電源、量測性能、感測器互相影響及水中暴露的測試。

## 下一步

編譯韌體、執行原生電路圖與 PCB 檢查，並以獨立參考標準進行測試。之後再評估與 pH 的互相影響、外殼性能、無線通訊及耗電。我們計畫在發布結果時，一併提供每項測試的條件與限制。

## 目前限制

SEN0244 是用於研究實驗性 EC 估算的 TDS 模組。AquaNode 準確度、長期水中運作及電池續航尚未確立。本版本不能辨識特定鹽類或評估飲用水安全，也不適用於海水。此套件未證實可用的無線網路或實地試辦。

## 開放工程

計畫以開源工作為基礎，保留原作者標示與授權。我們的近期目標是取得可重現的測試證據，支持後續開發，包括未來可能申請 MIT Solve；目前不表示已獲受理或具任何合作身分。

R0.3-EC-revB · 2026年10月29日。
本繁體中文版本依所提供的 copy_en.md／copy_ru.md 翻譯。新增圖面為網站的設計示意，非原生電路圖、原型照片或硬體測試結果。

文件：AquaNode · CC BY 4.0。原始工程套件與網站公開資料分開提供。
