toxonpf/aquaNode/AquaNode_R0.3_EC_revB/bench/Plan_ru.md

# План стенда и критерии приёмки
Все численные критерии ниже — предварительные инженерные цели, не уже достигнутые характеристики. Результаты пусты. Для каждой строки сохранять setup, дату, исполнителя, ревизию/хеш прошивки, прибор и его погрешность, raw-файл, критерий и pass/fail. Приборная неопределённость должна быть существенно меньше проверяемой границы (желательно ≤1/3). При выходе за электрические пределы выключить питание, не продолжать водные тесты.

## 0. Подготовка
Потребуются мультиметр, осциллограф с короткой землёй щупа, источник с ограничением тока/эмулятор батареи, нагрузки 1 кОм и 820 Ом, точный регулируемый источник 0–2,3 В для ADC, эталонный термометр, сертифицированные стандарты EC (2 fit + 1 независимый), чистые ёмкости и вода для промывки. Приборы/растворы можно взять в лаборатории: их стоимость не равна BOM буя. До включения выполнить native CAD checks и сборку ESP32 либо документировать отдельный разрешённый макет, который не выдаётся за проверку PCB.

## 1. Осмотр без питания — T01
R3 отсутствует; J7.2 кабельного контакта нет; W1 идёт только от TP5 к M1 VCC; C19 на J1.1; R19/R20/D3 и DS18B20 полярность подтверждены; J9 отсоединён, pH-проба вне воды. Проверить прозвонку жгута, отсутствие металлического короткого между 5V_PH и 3V3, соответствие маркировки. Омметр на полупроводниковой плате не считать точной проверкой номинала RC. Проверить положение модулей и отсутствие контакта Wio с чужими штырями. Приложить реальные фото после сборки, не заранее.

## 2. Питание — T02/T03
Сначала без датчика, с нагрузкой 1 кОм, затем 820 Ом. Подать питание через предусмотренные BAT-пады/USB; не подавать 5 В на 3V3. Лабораторный источник начать с ограничения, достаточного для безопасного поиска КЗ; если MCU не стартует из-за лимита, это не доказательство дефекта. Повышать лимит после проверки токов и рейтингов.

Проверить выбранную батарейную рабочую область (кандидат 3,3/3,7/4,2 В; нижняя точка уточняется после выбора pack), USB, подключение/отключение и 20 reset/power cycles. В ec_bench GPIO2 включает rail; первый запуск делать без M1. Осциллографом измерить BOOST_RAW, 5V_PH, 3V3 и EC_ADC.

Приёмка: установившийся 5V_PH 4,85–5,15 В; ни один рабочий/стартовый выброс на M1 выше 5,5 В; во время измерения не ниже 3,3 В. BOOST_RAW никогда выше рабочего максимума U8 6,0 В, с учётом погрешности щупа. Рекомендуемый целевой запас до него ≥0,2 В. При выключении сигнал GPIO не выходит за rails ESP32-S3 с допустимым datasheet допуском; нет устойчивой подпитки выключенной 3V3. Выключение rail через GPIO не равно снятию батареи. Не подключать внешнее питание к M1 в обход общего узла.

Повторить с M1. Паспортные 3–6 мА — ориентир нагрузки модуля, не ток всего буя. Зафиксировать реальные токи. Только после полного теста допускается SUPPLY_VALIDATED=true; при новой сборке сбросить.

## 3. ADC — T04
Отключить SEN0244 A; ввести через штатные R21/R4 точные 0,15; 0,25; 0,50; 1,00; 1,50; 2,00; 2,30 В с общей землёй. Вход не выводить за rails. На каждом уровне ≥100 записей; повторить с boost выключенным/включённым (для теста нужен отдельный переключаемый стендовый режим, EC-скетч держит его включённым). Сравнить с мультиметром на EC_ADC.

Цель: |ошибка медианы| ≤max(10 мВ, 1% приложенного напряжения); P90−P10 ≤10 мВ. Порог 40 мВ в прошивке — грубый reject, он не заменяет эту более строгую приёмку. При провале использовать новую разводку свободного ADS1115 AIN2 после удаления его GND, затем повторить; не маскировать нелинейность одной точкой.

## 4. Температура и ошибки — T05
25 °C и минимум две другие точки в 10–35 °C, рядом с эталоном, после равновесия. Цель |ошибка| ≤0,5 °C с учётом эталона. Отсоединение, короткий кабельный дефект и замена зонда должны приводить к null/reject, не к достоверному EC. 85/−127 °C не принимаются. Проверить восстановление после подключения. Не допускать попадания воды на негерметичный кабельный переход.

## 5. Стабилизация и калибровка — T06
При 25±0,5 °C снять ≥10 минут временного ряда с момента холодного старта; минимум 3 повтора. Кандидат стабилизации: изменение средней EC за последние 2 минуты ≤2% и отсутствие тренда больше этого порога. До наличия EC использовать относительную стабильность напряжения и затем повторить в EC. 60 секунд в прошивке не критерий. Подобрать два fit-стандарта и третий независимый, заполнить процедуру EC_calibration_ru.md. Сделать минимум 30 измерений каждого после стабилизации и 3 повторных погружения.

## 6. Независимая EC-проверка — T07
На независимом стандарте цель |ошибка| ≤max(50 мкСм/см, 10% эталона), CV ≤3% при ненулевой концентрации. Это желаемая пригодность проекта, не обещание на основе ±10% FS TDS. Если не достигнуто — диапазон/метод не принят, никакого заявления о точности. Отключение зонда SEN0244 может дать произвольное аналоговое значение: текущая схема не гарантирует обнаружение разрыва. Проверить отдельно и не считать статус estimated доказательством присутствия зонда.

## 7. Температурная модель — T08
Независимый стандарт при 10/15/25/35 °C, по его таблице EC(T); сравнить EC25 с сертифицированным значением при 25 °C. Повторить на втором составе/стандарте, если заявляется переносимость. Та же цель ошибки, что T07. До этого TEMPERATURE_VALIDATED=false; модель alpha=0,02/°C не универсальна. Уменьшать допустимый диапазон до фактически прошедшего тест.

## 8. pH/EC влияние — T09, отдельный этап
Сначала подтвердить конкретный pH AFE и его питание/выход. Измерить pH/EC по отдельности; затем с обоими электродами, включая pH без питания, pH с питанием, EC с питанием/без. Нельзя считать PH_EN=LOW развязкой. Предварительная цель сдвига: pH ≤0,05 и EC ≤max(20 мкСм/см, 2%), с подходящими эталонами. При провале: отдельные пробы или проверенная гальваническая изоляция и повторный бюджет. Не выдавать текущий EC-only стенд за этот тест.

## 9. Длительность, корпус, радио — T10/T11/T12
T10: 24 часа EC-лога после допуска, без необъяснённых перезапусков; провести контрольный стандарт до/после (цель дрейфа ≤5%). Затем 7 дней с учётом загрязнения/промывки, если планируется полевое применение.
T11: сначала пустой корпус с индикатором влаги, 60 минут в рабочих условиях и проверка остойчивости; затем электроника после успешного сухого теста. Это не IP-сертификация. Сохранить настоящие фото/условия.
T12: после реализации радио и выбора разрешённых частот — минимум 100 передач, ≥95% уникальной доставки в явно указанных условиях. Mesh — минимум 3 узла, невозможный прямой путь, отключение ретранслятора, проверка TTL/дубликатов. Нынешний скетч не реализует этот тест. Измерить энергопрофиль каждого режима; автономность выводить из реального среднего тока/энергии и полезной ёмкости.

## Публикация результатов
Сохранить и успешные, и провальные прогоны. В отчёте разделить «расчёт», «software test», «bench», «field». Каждое заявление о точности привязать к диапазону, температуре, экземпляру, дате и независимому стандарту. Для MIT Solve отдельно собрать подтверждения проблемы/пользовательских интервью и фактического эффекта; инженерные файлы не подтверждают пользователей или пилоты.
