toxonpf/aquaNode/AquaNode_R0.3_EC_revB/web_handoff/copy_ru.md

# AquaNode
## Изучать пресную воду, собирая собственный буй
AquaNode — проект доступного учебного буя для мониторинга пресной воды. Мы хотим дать школьникам возможность собирать устройство, работать с показаниями датчиков и учиться проверять свои выводы об окружающей среде.

## Сейчас: инженерная разработка
Мы подготовили редактируемые файлы схемы и платы, перечень компонентов, стендовый код и план испытаний. В текущей ревизии прорабатываем бюджетную оценку электропроводности на модуле SEN0244 и измерение температуры DS18B20. Питание и подключения описаны в новом инженерном пакете; их работу предстоит проверить на стенде.

## Что сделано
- Обновлены проектные файлы подключения экспериментального EC-канала и датчика температуры.
- Подготовлен исходный код стендового сбора показаний через USB и алгоритм калибровки.
- Программные сценарии обработки проверяются на синтетических данных. Они не заменяют испытаний датчика.
- Составлен план проверки питания, точности, взаимного влияния датчиков и работы в воде.

## Следующий шаг
Собрать прошивку, выполнить штатные проверки схемы и платы, провести стендовые измерения на независимых стандартах. Затем проверить совместную работу с pH, корпус, радиосвязь и энергопотребление. Мы будем публиковать результаты вместе с условиями и ограничениями испытаний.

## Границы текущего проекта
SEN0244 — TDS-модуль, который мы исследуем как недорогой источник экспериментальной оценки EC. Точность AquaNode, длительная работа в воде и автономность пока не подтверждены. Эта версия не определяет конкретные соли и пригодность воды для питья, не предназначена для морской воды. Радиосеть и полевой пилот текущим пакетом не подтверждаются.

## Открытая инженерная работа
Проект опирается на открытые разработки с сохранением авторства и лицензий. Наша ближайшая цель — получить воспроизводимые результаты испытаний и подготовить основания для дальнейшего развития проекта, включая возможную заявку MIT Solve.
