toxonpf/aquaNode/AquaNode_R0.3_EC_revB/baseline_r03/PCB.png

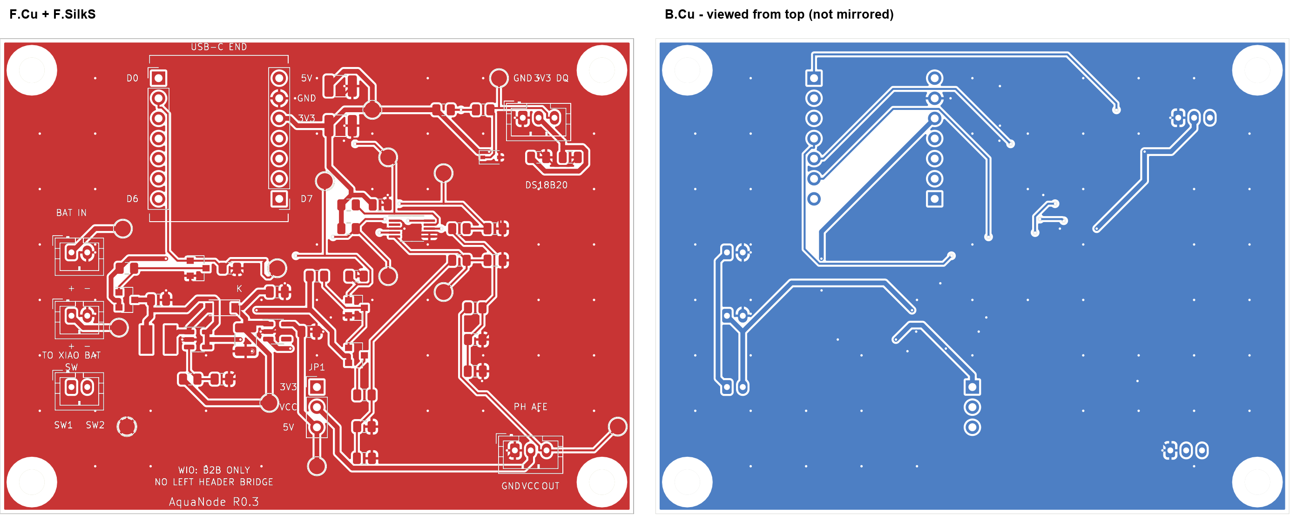
AquaNode_R0.3_EC_revB/baseline_r03/PCB.png
