toxonpf/aquaNode/assets-source/team/ayan-kuandyk-portrait.png

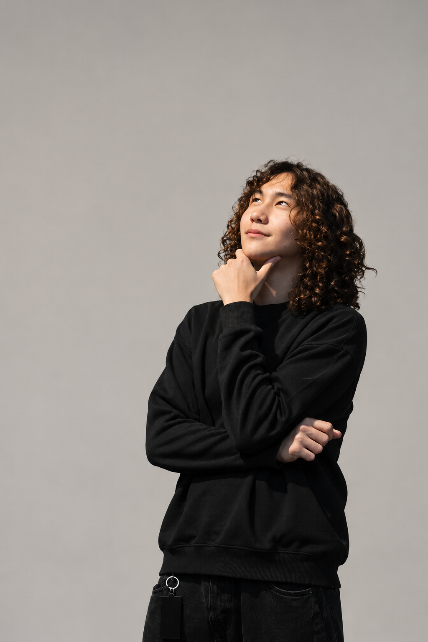
assets-source/team/ayan-kuandyk-portrait.png
