toxonpf/aquaNode/assets-source/team/roman-benzler-portrait.jpg

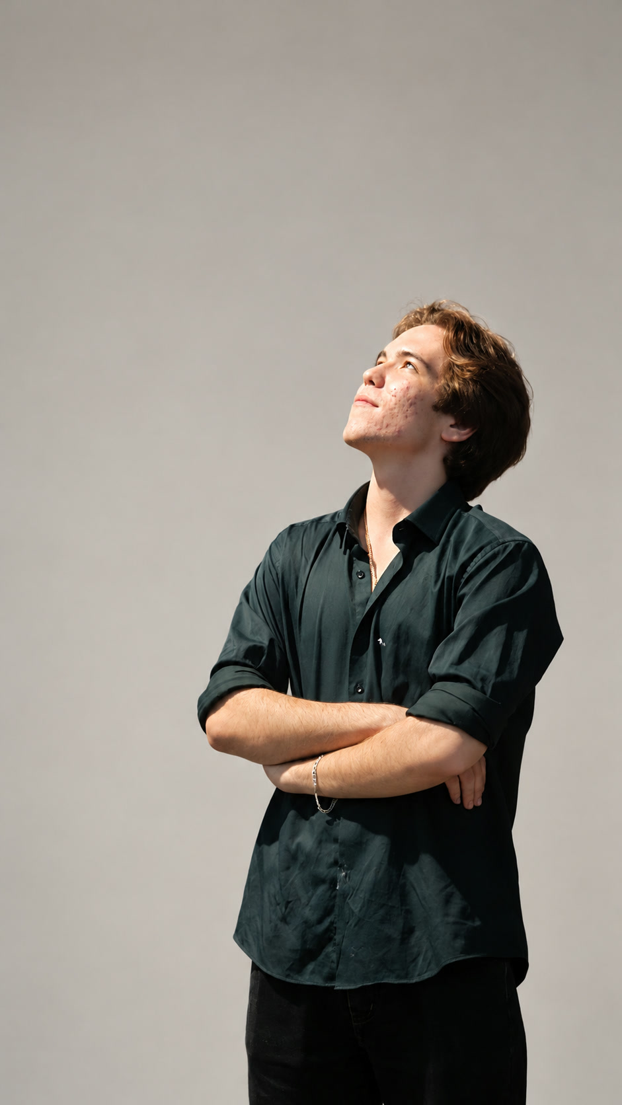
assets-source/team/roman-benzler-portrait.jpg
