toxonpf/aquaNode/assets-source/team/timur-kuandykov-portrait.jpg

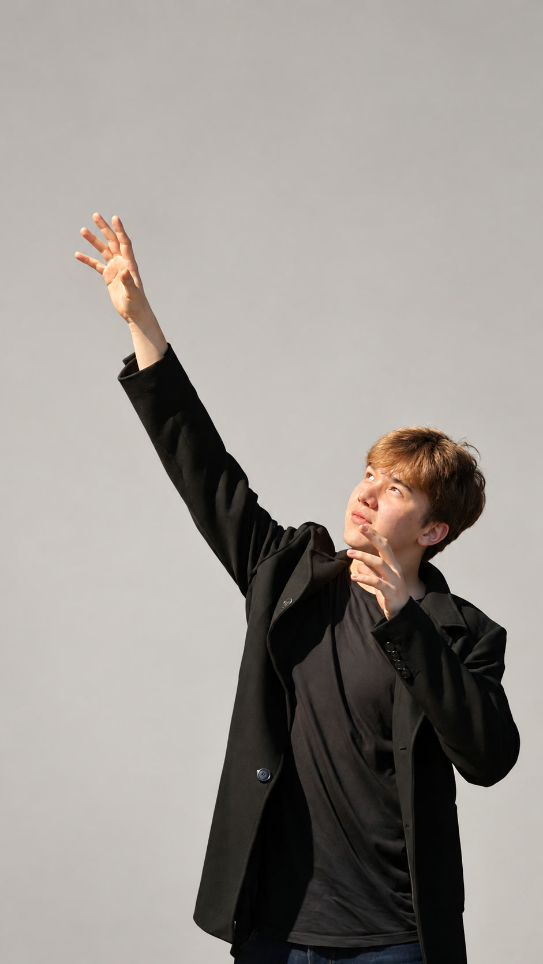
assets-source/team/timur-kuandykov-portrait.jpg
