toxonpf/aquaNode/public/assets/awards/geep-yic-2026-winner.webp

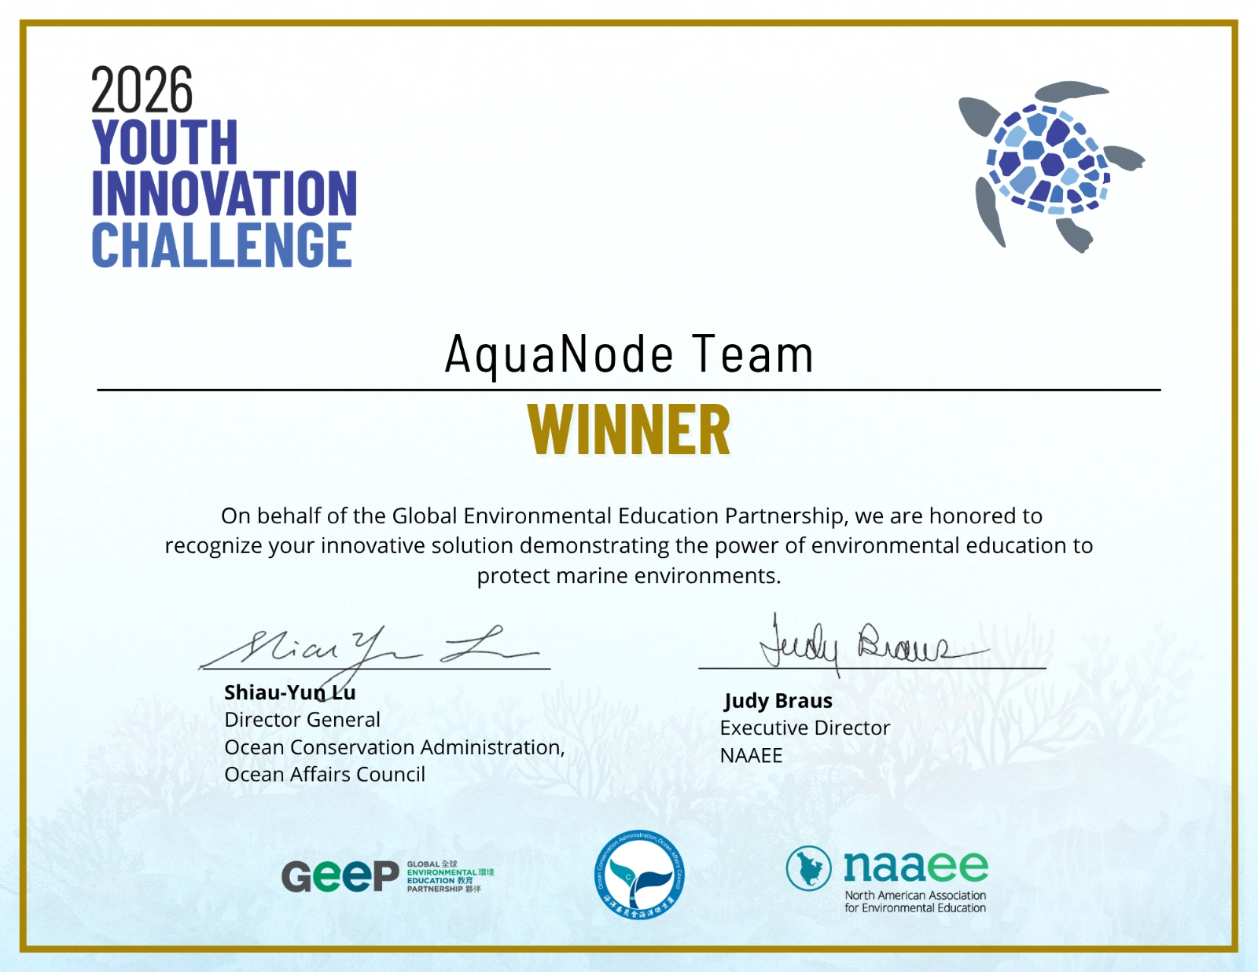
public/assets/awards/geep-yic-2026-winner.webp
