toxonpf/aquaNode/public/assets/team/ayan-kuandyk-portrait.webp

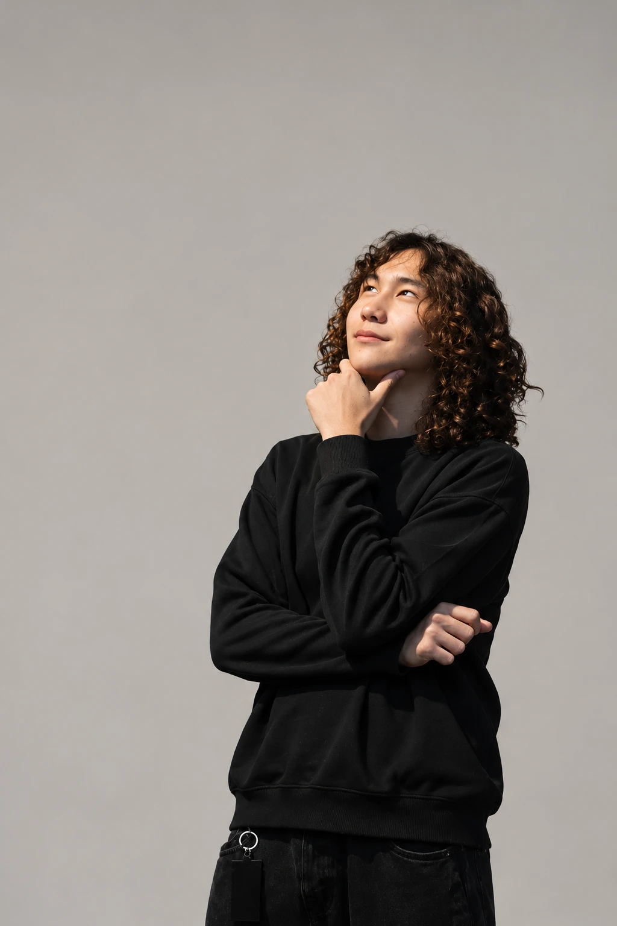
public/assets/team/ayan-kuandyk-portrait.webp
