toxonpf/aquaNode/public/assets/team/roman-benzler-portrait.webp

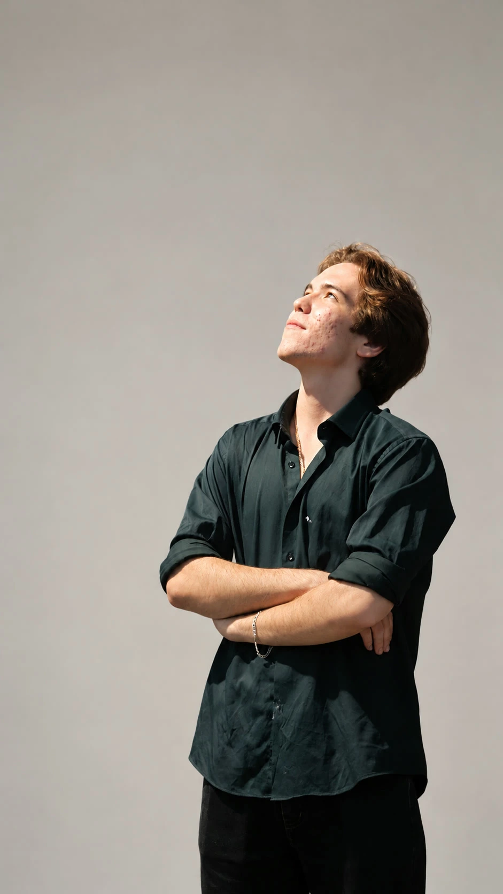
public/assets/team/roman-benzler-portrait.webp
