toxonpf/aquaNode/AquaNode_R0.3_EC_revB/EC_BOM_ru.md

# Бюджет и комплектация revB
Полный перечень несущей платы: engineering/BOM.csv. Внешняя сборка: M1 SEN0244, R19 4,7 кОм, R20 100 Ом, D3 PESD3V3S1BA, R21 1 кОм, C19 100 нФ, провод W1 и изолированная макетная плата. R3 не устанавливать. Старый R3 можно использовать как R19 после проверки.

Цена SEN0244 на странице производителя 29.10.2026: $11.80. Пассивы, провод и изоляция: плановый резерв $2–5, не предложение продавца. Итого доплата к уже укомплектованной R0.3: $13.80–16.80. Стандарты: плановый резерв $10–20, итог $23.80–36.80. Не включены доставка, налог, измерительное оборудование, повторный выпуск PCB, батарея, корпус, гермовводы и труд.

Перевод на существующий 5V_PH не добавляет преобразователя. Он допустим лишь если U7/U8 и окружающие детали уже установлены; вариант с DNP boost/LDO из старых документов здесь не подходит. Без проверки исходной комплектации невозможно обещать нулевую доплату за питание. Цена всего буя не установлена. Конкретный недорогой pH-модуль не утверждён и для EC-стенда не нужен.

Дорогой промышленный EC-датчик не подставлялся. SEN0244 остаётся TDS-модулем с экспериментальной оценкой EC, требующей независимой проверки.
Источник цены: https://www.dfrobot.com/product-1662.html
