toxonpf/aquaNode/AquaNode_R0.3_EC_revB/history_ec_revA/EC_BOM_ru.md

# Добавочная BOM: бюджетный EC

Цены USD, 29.10.2026. Только цена SEN0244 проверена на странице производителя; остальные строки — плановые резервы, не предложения магазина. Доставка, налоги, сборка не включены.

| Позиция | Количество | Назначение | Стоимость |
|---|---:|---|---:|
| M1 DFRobot SEN0244 | 1 | Зонд и аналоговая плата, https://www.dfrobot.com/product-1662.html | $11.80, проверено |
| R19 4.7 кОм | 1 | Подтяжка DS18B20 на новом GPIO; можно перенести снятый R3 | в резерве ниже |
| R20 100 Ом | 1 | Последовательная защита DS18B20 | в резерве |
| D3 PESD3V3S1BA | 1 | ESD на новом кабеле DS18B20 | в резерве |
| R21 1 кОм; C19 100 нФ | по 1 | Фильтр аналогового входа | в резерве |
| Провод, маленькая макетная плата, разъём, изоляция, пассивные детали | комплект | Внутри корпуса | резерв $2–5 |
| Стандарты EC: низкая точка и 1413 µS/cm, независимый проверочный стандарт | набор/доступ | Обязательны для вывода EC | резерв $10–20, уточнить |

Электроника канала: ориентир **$13.80–16.80**. Первый запуск с собственными стандартами: **$23.80–36.80** плюс доставка. Если стандарты есть в лаборатории, повторно покупать их не нужно. Дополнительный ADS1115 не приобретается. Имеющийся DS18B20 используется повторно. R3 на носителе — DNP.

## Сравнение рассмотренных вариантов

| Вариант | Цена производителя | Почему выбран/отклонён |
|---|---:|---|
| SEN0244 | $11.80 | Выбран как дешёвый экспериментальный тракт EC; нужен отдельный контроль точности |
| DFR0300 | $69.90 | EC-набор, но лабораторный зонд для периодических измерений; https://www.dfrobot.com/product-1123.html |
| SEN0706 | $149 | Готовый промышленный RS485 EC для длительного погружения; дороже и требует другого питания/интерфейса; https://www.dfrobot.com/product-3100.html |
| SEN0451 | $199 | Промышленный аналоговый EC для 24/7; вне бюджетного варианта; https://www.dfrobot.com/product-2565.html |

SEN0244 не выдаётся за эквивалент промышленных вариантов. При неприемлемых результатах контрольных измерений этот бюджетный канал бракуется, а не объявляется точным программной коррекцией.
