toxonpf/aquaNode/public/models/rubber-duck/textures/Material_0_baseColor.png

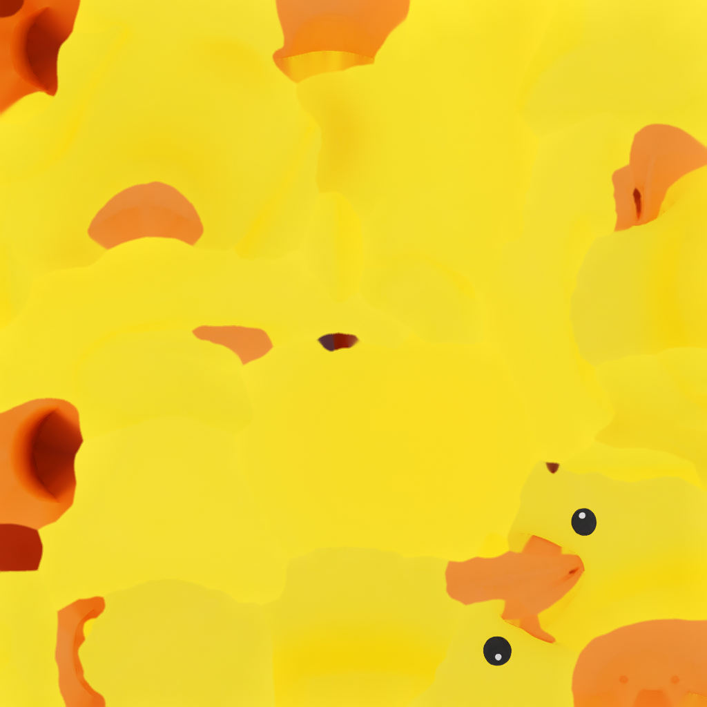
public/models/rubber-duck/textures/Material_0_baseColor.png
