toxonpf/aquaNode/AquaNode_R0.3_EC_revB/manufacturing/README_ru.md

# HOLD — НЕ ДЛЯ ИЗГОТОВЛЕНИЯ
Новые Gerber, Excellon и native Schematic.pdf не выпущены: KiCad CLI не установлен и загрузка недоступна по DNS. Старый PDF перенесён в history_ec_revA/Schematic.pdf. baseline_r03 содержит только исторический выпуск.

Не заказывать PCB по baseline, выдавая её за проверенную revB. Медь revB сохранена, но маркировка и сборка изменены, а внешний жгут не помещён на PCB. Требуется независимый просмотр схемы и PCB, штатные ERC/DRC, проверка соответствия netlist и физического pinout, механики XIAO/Wio, контроль DNP R3 и кабеля J7.2.

Порядок выпуска:
1. Открыть cad/AquaNode.kicad_pro в совместимом KiCad; проверить разрешение локальных библиотек и всех символов.
2. Запустить repro/check_cad.ps1; проанализировать каждый diagnostic. Нулевой код сам по себе недостаточен без проверки severity/exclusions.
3. Сверить схему с PCB, внешней сборкой и BOM. Не проталкивать external symbols на PCB автоматически.
4. Экспортировать актуальный Schematic.pdf, проверить читаемость всей A1-страницы и внешней сборки.
5. После закрытия ошибок экспортировать Gerber/Excellon в новую папку release; посмотреть все слои CAM, границу, сверловку, silk, маску, полярности.
6. Выпустить подписанный release manifest с версиями KiCad, хешами и ответственным. Аппаратный статус остаётся «не испытано» до стенда.

Connection_review.pdf — только таблица внешних соединений, не электрическая принципиальная схема и не документ для фабрики.
