toxonpf/aquaNode/AquaNode_R0.3_EC_pH_revC/checks/Verification_ru.md

# Результаты проверки revC — 02.11.2026

| Проверка | Результат |
|---|---|
| Выводы KiCad-схемы ↔ design.json | PASS: 166 выводов |
| Контакты PCB ↔ design.json | PASS: 139 нумерованных площадок |
| Унаследованная геометрия меди и расположение площадок ↔ исходный revB | Без изменений |
| Разделение изолированных pH-сетей в исходниках | PASS: только M3/M4 |
| DNP R3 и цепи делителя pH / AIN0 / I²C | PASS по исходникам |
| Python unit tests | PASS: 18 тестов (15 унаследованных + 3 pH exporter) |
| Python, JSON, KiCad S-expression синтаксис | Разобраны без ошибок |
| Полная ESP32 сборка | НЕ ВЫПОЛНЕНА: установка platform esp32:esp32@3.3.2 сорвалась на загрузке зависимости |
| C++ pH-model assertions | Подготовлены, НЕ ЗАПУЩЕНЫ: доступный host C++ compiler отсутствует |
| Native KiCad ERC/DRC, netlist/PDF export | НЕ ЗАПУЩЕНЫ: kicad-cli отсутствует |
| Измерения на аппаратуре, калибровка, герметичность | НЕ ВЫПОЛНЕНЫ |

Фактический лог попытки сборки — `firmware_build.txt`; там отсутствие установленной ESP32 платформы, а не успешная компиляция. Arduino CLI 1.5.2-rc.1 запускался локально; библиотеки OneWire 2.3.8 и DallasTemperature 4.0.6 установлены. Загрузка зависимости `esp32-arduino-libs@idf-release_v5.5-07e9bf49-v1` (428,11 MiB) была прервана сетевой ошибкой: `An established connection was aborted by the software in your host machine`. Наличие библиотек не заменяет сборку.

`ph_model_test.cpp` содержит 15 проверок того же C++ заголовка, который использует прошивка. Они не включены в число 18 выполненных Python-тестов. Попытка получить отдельный host-компилятор также не завершилась; результат не заявляется как PASS.

Исходниковая сверка соединений не проверяет все правила KiCad, физическую пайку, токовый запас, посадочные места, изоляционные расстояния или точность датчиков. Native ERC/DRC и реальные измерения остаются обязательными перед выпуском.

Сырые аппаратные результаты и осциллограммы не создавались. Коэффициенты pH/EC оставлены NAN, флаги калибровки/допуска false. Чтение AIN0 в прошивке включено; `null` численного pH означает отсутствие допуска калибровки, а не физическое отключение электрода.
