toxonpf/aquaNode/AquaNode_R0.3_EC_revB/history_ec_revA/Verification_ru.md

> **R0.3-EC, 29.10.2026:** исходный текст R0.3 ниже является базовой документацией. Для текущей сборки приоритет имеют EC_integration_ru.md и EC_BOM_ru.md: R3 отсутствует; J7 используется для EC; DS18B20 перенесён на D6/GPIO43. Старые ERC/DRC и Gerber находятся в baseline_r03 и не подтверждают новую сборку.

# Проверка выпуска AquaNode R0.3

20 октября 2026. Проверка выполнена в KiCad 8.0.9. Это результаты проверки цифрового проекта, а не физического образца.

| Проверка | Результат |
|---|---|
| Native ERC | 0 замечаний всех уровней |
| Native DRC | 0 замечаний всех уровней |
| Неразведённые соединения | 0 |
| Пересечения courtyard | 0 по DRC |
| Схема ↔ перечень цепей ↔ PCB | 130 именованных площадок, 0 расхождений |
| U8.3 / EN | BOOST_IN |
| SMD в контуре XIAO с доступом 4 мм ниже торца | 0 пересечений |
| Переходы GND | 71, диаметр 0,6 мм / сверло 0,3 мм |
| Всего переходов / сегментов дорожек | 85 / 374 |
| Силовые линии | 0,6 мм; у U1.8 сужение 0,25 мм длиной 1,5 мм |
| Локальный возврат преобразователя на B.Cu | 0,8 мм |
| Длина дорожек BOOST_SW | 6,832 мм |

Сырые результаты: [ERC](checks/ERC.json), [DRC](checks/DRC.json), [сверка цепей](checks/pin_comparison.json), [геометрия и ширины](checks/layout_metrics.json). Нативный экспорт схемы сохранён в checks/native_netlist.net.

## Ближайшие земляные переходы

Расстояние измерено от центра площадки до центра перехода; это не зазор меди. Для сквозных разъёмов сама площадка также соединяет слои.

| Площадка | Координаты перехода, мм | Расстояние, мм |
|---|---|---|
| U7.2 | 23; 38 | 0.863 |
| C7.2 | 20.95; 31.8 | 1.200 |
| C8.2 | 31.8; 39.475 | 0.800 |
| C9.2 | 35.95; 30.9 | 1.100 |
| U8.2 | 32.9; 37 | 0.963 |
| C10.2 | 40.8; 37 | 0.850 |
| U1.3 | 51.05; 24 | 1.250 |
| C1.2 | 48.95; 19.75 | 1.250 |
| C17.2 | 43.475; 6 | 1.000 |
| C18.2 | 43.475; 11 | 1.000 |
| J2.6 | 37.24; 7.54 | 2.000 |
| J3.2 | 12; 27 | 1.000 |
| J4.2 | 12; 34.75 | 1.031 |
| J7.1 | 65; 10 | 1.000 |
| J9.1 | 64; 52 | 1.000 |

## Экспорт и просмотр

Перегенерированы шесть Gerber-слоёв (F.Cu, B.Cu, F.Mask, B.Mask, F.Silkscreen, Edge.Cuts), файл задания Gerber и Excellon. Файлы находятся в fabrication_review/. Отдельный CAM round-trip и проверка изготовителем не выполнены. Перед заказом сверить слои и сверловку в просмотрщике изготовителя.

Schematic.pdf экспортирован нативно из KiCad; схема и PNG слоёв/сборки проверены визуально. PCB_B.png показан сверху, без зеркального отражения. PNG верхнего слоя объединяет изображение меди с отдельным экспортом шелкографии; исходный SVG KiCad может отображать шелкографию под непрозрачной заливкой в некоторых просмотрщиках.

## Что ещё не проверено

Физически не проверены посадка стека XIAO/Wio и BAT-проводов, распиновка купленного AFE, переходные процессы включения/выключения, шум и нагрузочная погрешность АЦП, ток сна, радиоканал, калибровка и герметичность. Прошивка и mesh не реализованы этим выпуском. ERC/DRC не подтверждают соответствие радио-нормам или требованиям отбора MIT.

Утверждение «16 SPS и RC полностью устраняют ошибку ADS1115» не подтверждено. Расчёт типовой остаточной нагрузки и метод проверки приведены в Analog_calculations_ru.md. Условия испытаний и результаты должны быть добавлены после сборки.

## Что проверено в этой редакции

Структурная сверка изменённых сетей и комплектности, сохранение геометрии меди, программные тесты обработки EC. Результаты — checks/EC_static.json. Старый native netlist/DRC/ERC относится только к baseline_r03. Новый нативный ERC/DRC и сборка ESP32 не выполнены. Gerber для новой сборки не выпускался.
