toxonpf/aquaNode/AquaNode_R0.3_EC_pH_revC/test_tools/README_ru.md

# Проверки и журналы
Python 3.12+; ec_model.py, export_calibration.py и unit tests используют стандартную библиотеку. log_capture.py дополнительно требует pyserial. Скрипты доставки сохранены для будущих независимых TX/RX-логов; они не подтверждают существование радио/mesh в прошивке.

Из корня пакета: `python -m unittest discover -s test_tools -p "test_*.py" -v`.
Калибровка: `python test_tools/ec_model.py --low-v <измерено> --low-ec <сертификат> --high-v <измерено> --high-ec <сертификат> --cal-id <ID>`. Угловые скобки здесь означают обязательные реальные значения, не готовую команду. Сохранить JSON, затем `python test_tools/export_calibration.py real_cal.json --out calibration_candidate.h` и проверить файл. Генератор отказывается перезаписывать существующий файл и отклоняет идентификаторы SYNTHETIC. Acceptance flags остаются false.

Лог реального стенда: `python test_tools/log_capture.py --port COM5 --run-id bench-001 --role bench --out bench-001.jsonl` (COM5 заменить). Не создавать этот файл заранее: он открывается только на запись нового результата. Сохраняются исходные байты, время хоста и ошибка разбора. Наличие синтетического JSON никогда не считать записью устройства.

Проверка исходных соединений: `python repro/verify_connections.py` (стандартная библиотека). Скрипт не является ERC/DRC. Результаты native-проверок получать отдельно в установленном KiCad.

pH: `export_ph_calibration.py` формирует заголовок из реальных милливольт AIN0 всей цепи. Формат измерений и приёмка описаны в `bench/Plan_ru.md`. `ph_model_test.cpp` проверяет тот же заголовочный C++-модуль, который использует прошивка; собирается обычным C++11+ компилятором, например `c++ test_tools/ph_model_test.cpp -o ph_model_test`, затем запускается. Это синтетические тесты математики и отбраковки, не реальные pH-измерения.
