toxonpf/aquaNode/AquaNode_R0.3_EC_revB/EC_calibration_ru.md

# Калибровка экспериментальной EC
Сначала пройти электрические проверки и ADC sweep из bench/Plan_ru.md. Пробы — пресная вода, без второго электрода в ёмкости. По умолчанию диапазон температуры выдачи результата 25±0,5 °C; 10–35 °C — только программная граница после отдельной температурной валидации. Это не паспортный диапазон точности устройства.

1. Подготовить два сертифицированных стандарта EC, охватывающих интересующий диапазон, и независимый третий стандарт. Не разводить раствор «на глаз». Учитывать температурную таблицу/сертификат каждого стандарта. Предел модели 2000 мкСм/см не является подтверждённым диапазоном SEN0244.
2. Довести до 25±0,5 °C, промыть между пробами. Зафиксировать серийный номер зонда, партию и срок раствора, температуру эталона, питание, ADC и установившуюся медиану.
3. Подставить измеренные вольты и EC стандартов в ec_model.py. Требуются 0,15–2,30 В и расстояние точек минимум 0,10 В; невозможность получить такие точки означает, что выбранный диапазон не поддержан этим алгоритмом.
4. Вычисляется fit gain*curve(V)+offset, curve(V)=133.42V³−255.86V²+857.39V. Коэффициенты полинома атрибутированы DFRobot, новая двухточечная аппроксимация экспериментальная. Это не заводской EC-алгоритм и не анализ соли.
5. Температурная модель делит оценку на 1+alpha*(T−25), alpha=0,02/°C как гипотеза. Она отличается от примера DFRobot с компенсацией напряжения перед полиномом. Ни один вариант не следует считать валидированным для всех смесей и температур; поэтому температурная выдача по умолчанию закрыта.
6. Провести независимый третий стандарт, повторяемость и температурные точки. Не подгонять и не проверять точность на тех же данных. Сохранить исходные журналы даже при провале.
7. Сгенерировать calibration.h только из реального JSON. Утверждённый диапазон — пересечение электрических, калибровочных и реально проверенных условий. Повторить после смены датчика, ADC, питания или проводки.

Численное EC при estimated остаётся экспериментальной оценкой. Перевод TDS↔EC коэффициентом 0,5 — допущение состава, не универсальная физическая константа. На сайте не показывать ppm или солёность на основании этого алгоритма.
