toxonpf/aquaNode/AquaNode_R0.3_EC_revB/history_ec_revA/EC_calibration_ru.md

# Калибровка и честные пределы EC

SEN0244 — TDS-модуль с паспортной точностью TDS ±10% полной шкалы при 25 °C. У него нет заявленной здесь паспортной точности EC. Приведённый канал — экспериментальная оценка проводимости, а не замена лабораторного EC-метра. Не выводить «солёность моря» или ppm соли.

## Модель

Исходная характеристика взята из опубликованной математической зависимости DFRobot без множителя TDS 0.5: P(v)=133.42v³−255.86v²+857.39v. Это стартовая модель в эквивалентных µS/cm, не доказанный диапазон EC. Мы калибруем всю цепь по стандартам EC при 25±0.5 °C: ec_T=gain×P(v)+offset. Нормировка ec25=ec_T/[1+alpha×(T−25)], alpha по умолчанию 0.02/°C — приближение, зависящее от состава воды. Это отличается от примера производителя, где температурная коррекция приложена к напряжению; поэтому нашу нормировку требуется независимо проверять при нескольких температурах.

Значения gain/offset по умолчанию не заданы, EC=null. Для начала взять свежие стандарты 147 и 1413 µS/cm при 25 °C (или другие две известные точки, охватывающие предполагаемую воду). Низкая точка должна давать ADC ≥150 мВ; при меньшем сигнале нельзя использовать её в этой конфигурации. Если стандарты отсутствуют, публиковать только raw/mV и температуру, не EC.

1. Проверить ADC мультиметром на нескольких напряжениях примерно 0.2/0.8/1.5/2.2 В через реальный фильтр. Выбросы, скачки или нелинейность сначала устранить аппаратно. Не подавать 5 В на GPIO.
2. Поместить EC и DS18B20 рядом в первый стандарт, без контакта со стенкой и пузырьков. Дождаться температуры и показаний; стартовая выдержка 60 секунд — только минимум стенда, не гарантия стабилизации. Записать медиану напряжения за стабильный участок. Повторить со вторым стандартом после промывки.
3. Запустить test_tools/ec_model.py с реальными напряжениями и значениями стандартов, получить калибровочный JSON. Перенести рассчитанные параметры в firmware/ec_bench/calibration.h, сменить CAL_ID на дату/экземпляр; повторно прошить.
4. Проверить независимый стандарт между точками, затем повторить при двух других температурах, допустимых для эталона, по его таблице. Точки подгонки не считать независимой проверкой. Сохранить все исходные данные.
5. Внутренняя начальная цель — ошибка не более max(50 µS/cm, 10% показания) в проверенном интервале. Это выбранный критерий приёмки, не обещанная точность. При провале EC не выпускать как валидный канал.

Прошивка ограничивает работу 10–35 °C, ADC 150–2300 мВ и интервалом фактической калибровки. Математический эквивалент 0–2000 µS/cm из TDS-шкалы **не является подтверждённым рабочим диапазоном**. Код запрещает экстраполяцию за калибровочные напряжения и EC-границы. Вода вне диапазона, ошибка температуры, нестабильный ADC или отсутствие калибровки дают EC=null и статус.

Простой аналоговый датчик не позволяет надёжно отличить обрыв зонда от очень низкой проводимости. Поэтому нулевой сигнал не объявляется чистой водой: это invalid/ниже рабочего диапазона. Насыщение датчика в чрезмерно проводящей воде может быть неотличимо от нормального верхнего значения — допустимость среды проверяется отдельно, морские пробы запрещены.

Калибровку повторять после изменения питания, проводов, ADC-настроек, зонда или монтажа; проверять контрольный раствор перед и после погружения. В первом пилоте осматривать и проверять зонд ежедневно, затем выбирать интервал по измеренному дрейфу. Конкретный срок ресурса не установлен.
