toxonpf/aquaNode/AquaNode_R0.3_EC_revB/history_ec_revA/Netlist_ru.md

# Соединения R0.3-EC

Логическая таблица сборки из design.json; не нативный экспорт KiCad. R3 DNP исключён из установленных связей. В PCB его пустые площадки остаются. M1/M2 и R19/R20/D3/R21/C19 находятся вне носителя.

| Сеть | Контакты установленной сборки |
|---|---|
| 3V3 | C1.1, C15.1, C16.1, C17.1, C18.1, J2.5, J7.2, M1.2, M2.2, Q1.2, R1.1, R19.1, R2.1, R5.1, TP3.1, U1.8 |
| 5V_PH | C10.1, JP1.3, TP5.1, U8.5 |
| ADC_BAT | C14.1, R16.2, TP14.1, U1.5 |
| ADC_PH | C13.1, R15.2, TP13.1, U1.4 |
| BAT_DIV | C12.1, R11.2, R12.1, R16.1 |
| BAT_EN | J1.4, Q4.1, R18.1, TP4.1 |
| BAT_GATE | Q3.1, Q4.3, R17.2 |
| BAT_SENSE | Q3.3, R11.1 |
| BOOST_FB | R7.2, R8.1, U7.3 |
| BOOST_IN | C7.1, JP1.1, L1.1, Q1.3, U7.4, U7.5, U8.3 |
| BOOST_RAW | C8.1, C9.1, D1.1, R7.1, TP12.1, U8.1 |
| BOOST_SW | D1.2, L1.2, U7.1 |
| DS_CABLE | D3.1, M2.3, R20.2 |
| DS_LOCAL | J1.7, R19.2, R20.1 |
| EC_ADC | J1.1, R4.1 |
| EC_FILTERED | C19.1, D2.1, J7.3, R21.2, R4.2, TP9.1 |
| EC_OUT | M1.3, R21.1 |
| GND | C1.2, C10.2, C11.2, C12.2, C13.2, C14.2, C15.2, C16.2, C17.2, C18.2, C19.2, C7.2, C8.2, C9.2, D2.2, D3.2, J2.6, J3.2, J4.2, J7.1, J9.1, M1.1, M2.1, Q2.2, Q4.2, R10.2, R12.2, R18.2, R6.2, R8.2, TP6.1, U1.1, U1.3, U1.6, U1.7, U7.2, U8.2 |
| I2C_SCL | J1.6, R2.2, TP8.1, U1.10 |
| I2C_SDA | J1.5, R1.2, TP7.1, U1.9 |
| PH_DIV | C11.1, R10.1, R15.1, R9.2 |
| PH_EN | J1.2, Q2.1, R6.1, TP11.1 |
| PH_GATE | Q1.1, Q2.3, R5.2 |
| PH_OUT | J9.3, R9.1, TP10.1 |
| PH_SUPPLY | J9.2, JP1.2 |
| VBAT | J4.1, J5.2, Q3.2, R17.1, TP2.1 |
| VBAT_RAW | J3.1, J5.1, TP1.1 |

J7 = GND/3V3/EC_FILTERED. J1.7 = D6/GPIO43. JP1.1 = BOOST_IN (переключаемые 3.3 В).
