toxonpf/aquaNode/AquaNode_R0.3_EC_revB/history_ec_revA/EC_integration_ru.md

# Монтаж R0.3-EC

## Что меняется

1. Полностью отключить USB и батарею. Снять **R3 4.7 кОм** с носителя; оставить его место пустым. Резистор можно использовать как R19 на внешней платке. Если R3 оставить, он будет подтягивать выход EC к 3.3 В.
2. Отключить DS18B20 от J7. Подписать J7 «EC G / 3V3 / ANALOG». Старая шелкография DS18B20 больше не соответствует сборке.
3. Подключить SEN0244 и внешний фильтр по таблице. Его плата и все соединения остаются в сухом корпусе.
4. DS18B20 подключить через новую цепь к J1.7 (D6/GPIO43). Не использовать UART0 TX на этом выводе; журнал только через USB CDC.

| Откуда | Куда | Условие |
|---|---|---|
| J7.1 GND | SEN0244 «−», C19.2 | Общая земля |
| J7.2 3V3 | SEN0244 «+» | Проверить реальное напряжение на плате датчика под нагрузкой |
| SEN0244 «A» | R21.1 | Аналоговый сигнал |
| R21.2 | J7.3 и C19.1 | R21=1 кОм; C19=100 нФ на землю |
| J7.3 → существующий R4=100 Ом → J1.1 | D0 / GPIO1 / ADC1 | R3 отсутствует; D2 ESD сохранён |
| TP3 3V3 | DS18B20 VDD и R19.1 | Трёхпроводное питание, не паразитное |
| TP6 GND | DS18B20 GND и D3.2 | Общая земля |
| J1.7 / GPIO43 | R19.2 и R20.1 | Подтяжка R19=4.7 кОм к 3V3 |
| R20.2 | DS18B20 DQ и D3.1 | R20=100 Ом, D3=PESD3V3S1BA |

Номера выводов M1/M2 в CAD — номера логических контактов нашей схемы, не цветовая схема кабеля. Полярность конкретного зонда прозвонить. Внешние компоненты монтируются на изолированной платке с разгрузкой проводов. Аналоговый провод внутри корпуса делать коротким, до 100 мм, вдали от boost, антенны и цифровых линий. Кабель зонда без необходимости не удлинять.

## Ограничения питания и входа

SEN0244 заявлен для 3.3–5.5 В, выход до 2.3 В. Питание от номинальной шины 3V3 — минимальная бюджетная конфигурация, но допуск регулятора XIAO может вывести напряжение ниже 3.3 В. **До приёмки измерить питание датчика в запуске и под нагрузкой; если ниже 3.3 В, эту конфигурацию нельзя считать соответствующей паспорту.** Не поднимать всю шину XIAO. Потребуется отдельное согласованное питание датчика и повторная проверка входа при выключении; неподтверждённую переделку здесь не выдаём за готовую.

GPIO1 настроен как аналоговый вход, без подтяжек, ADC_11db. Используется analogReadMilliVolts и медиана; это не устраняет нелинейность, шум и температурный дрейф ADC. Производитель SEN0244 для ESP32 рекомендует внешний ADS1115; здесь его дополнительная покупка сознательно исключена ради бюджета. При плохих результатах проверки дешевизна не оправдывает неверные данные.

R21/C19 дают постоянную времени около 0.1 мс, но время стабилизации самого датчика больше. Фильтр не является гальванической изоляцией. На выключенном узле запрещено подавать сигнал от отдельно питаемого EC-модуля в GPIO; штатно они питаются одной шиной. D2 — ESD, не защита от любого перенапряжения.

## EC и pH в одной воде

EC возбуждает электрод переменным сигналом; общий электролит и земли могут вносить ошибку pH. Сначала проверить EC в отдельном образце без pH-электрода. Затем сравнить EC и pH по отдельности и вместе. Простое PH_EN=0 не гарантирует изоляции электрода. До успешной проверки допустим отдельный режим EC или физическое извлечение другого зонда; для одновременного непрерывного измерения при обнаруженных помехах нужна гальваническая развязка. Она не включена в бюджет этой версии.

## Потребление и погружение

Плата EC постоянно питается в этом варианте; паспортные 3–6 мА дают 9.9–19.8 мВт от 3.3 В, или 0.238–0.475 Wh/сутки только на датчик. Не обещать прежнюю автономность. Скетч стендовый, без сна. Автоматическое отключение EC можно добавить отдельной проверенной силовой цепью позже; напрямую от GPIO его не питать.

DFRobot допускает длительное погружение зонда SEN0244, но не его разъёма и платы. Это не гарантия многомесячной стабильности при обрастании. Защитить зонд от ударов, сохранять свободный обмен водой, обеспечить доступ для промывки и повторной калибровки. Эксплуатация только в пресной воде и в пределах проверенного диапазона. Состав солей, загрязнение и безопасность питья этот канал не определяет.
