toxonpf/aquaNode/(list of files, drawings)

Other design files:
AquaNode_R0.3_EC_revB/baseline_r03/checks/pcb_pins.json
