toxonpf/aquaNode/AquaNode_R0.3_EC_pH_revC/cad/AquaNode.kicad_pcb

## KiCad design AquaNode_R0.3_EC_pH_revC/cad/AquaNode.kicad_pcb (2026-11-02)

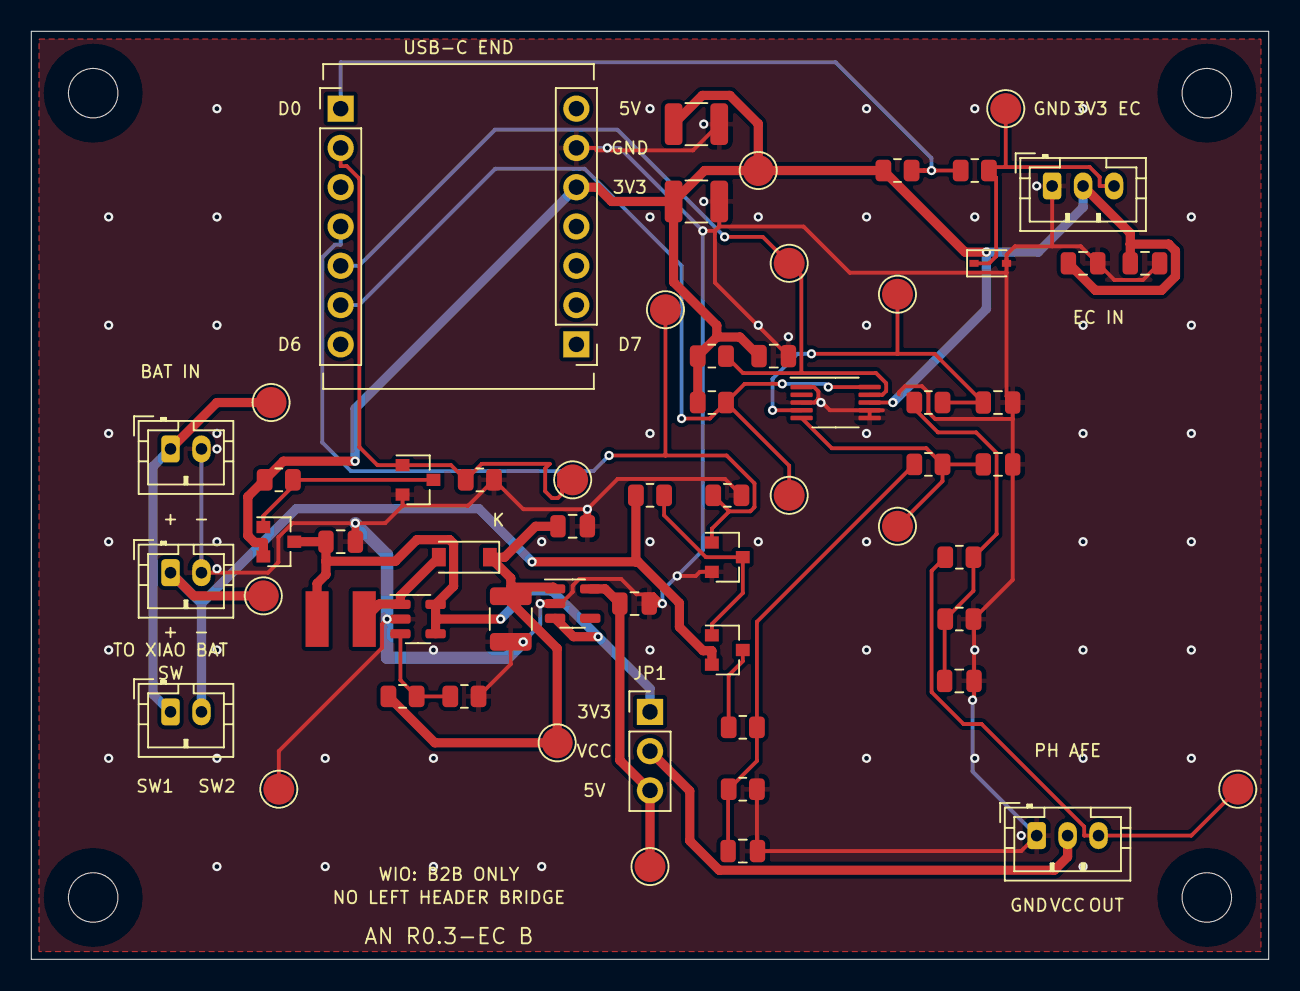
[picture p13: board AquaNode.kicad_pcb from above]

Board: 2 copper layers, 80.0 x 60.0 mm, 65 parts (0 on the bottom side), 24 nets.

Parts:
C1, C13, C14, C15: 100nF; C_0805_2012Metric
C7, C10: 10uF; C_0805_2012Metric
C8, C17, C18: 22uF; C_1210_3225Metric
C9, C11, C12, C16: 1uF; C_0805_2012Metric
D1: Schottky 20V; D_SOD-123
D2: EC input ESD; D_SOD-323
H1, H2, H3, H4: M3 NPTH; MountingHole_3.2mm_M3
J1: XIAO_LEFT_D0..D6; PinHeader_1x07_P2.54mm_Vertical
J2: XIAO_RIGHT_D7..5V; PinHeader_1x07_P2.54mm_Vertical
J3: BATTERY + -; JST_PH_B2B-PH-K_1x02_P2.00mm_Vertical
J4: TO XIAO BAT PADS; JST_PH_B2B-PH-K_1x02_P2.00mm_Vertical
J5: SPST BATTERY SWITCH; JST_PH_B2B-PH-K_1x02_P2.00mm_Vertical
J7: EC G / 3V3-NO-CABLE / A; JST_PH_B3B-PH-K_1x03_P2.00mm_Vertical
J9: PH ISOLATED RETURN G / NC / A; JST_PH_B3B-PH-K_1x03_P2.00mm_Vertical
JP1: PH POWER 3V3 / 5V; PinHeader_1x03_P2.54mm_Vertical
L1: 10uH 1.4A sat; L_Bourns_SRN4018_Custom
Q1: P-MOS high side; SOT-23
Q2: N-MOS gate driver; SOT-23
Q3: Battery sense P-MOS; SOT-23
Q4: Battery sense driver; SOT-23
R1, R2: 4.7k; R_0805_2012Metric
R3: DNP - REMOVE 4.7k; R_0805_2012Metric
R4: 100R; R_0805_2012Metric
R5, R6, R18: 100k; R_0805_2012Metric
R7: 69.8k 0.1%; R_0805_2012Metric
R8: 20k 0.1%; R_0805_2012Metric
R9, R10: 49.9k 0.1%; R_0805_2012Metric
R11, R12: 100k 0.1%; R_0805_2012Metric
R15, R16: 1k; R_0805_2012Metric
R17: 1M; R_0805_2012Metric
TP1: VBAT_RAW; TestPoint_Pad_D2.0mm
TP2: VBAT; TestPoint_Pad_D2.0mm
TP3: 3V3; TestPoint_Pad_D2.0mm
TP4: BAT_EN; TestPoint_Pad_D2.0mm
TP5: 5V_PH; TestPoint_Pad_D2.0mm
TP6: GND; TestPoint_Pad_D2.0mm
TP7: I2C_SDA; TestPoint_Pad_D2.0mm
TP8: I2C_SCL; TestPoint_Pad_D2.0mm
TP9: EC_FILTERED; TestPoint_Pad_D2.0mm
TP10: PH_OUT; TestPoint_Pad_D2.0mm
TP11: PH_EN; TestPoint_Pad_D2.0mm
TP12: BOOST_RAW; TestPoint_Pad_D2.0mm
TP13: ADC_PH; TestPoint_Pad_D2.0mm
TP14: ADC_BAT; TestPoint_Pad_D2.0mm
U1: ADS1115; VSSOP-10_3x3mm_P0.5mm
U7: TPS61040; SOT-23-5
U8: 5V LDO; SOT-23-5

Connections:
3V3: C1.1, C15.1, C16.1, C17.1, C18.1, J2.5, J7.2, Q1.2, R1.1, R2.1, R3.1, R5.1, TP3.1, U1.8
5V_PH: C10.1, JP1.3, TP5.1, U8.5
ADC_BAT: C14.1, R16.2, TP14.1, U1.5
ADC_PH: C13.1, R15.2, TP13.1, U1.4
BAT_DIV: C12.1, R11.2, R12.1, R16.1
BAT_EN: J1.4, Q4.1, R18.1, TP4.1
BAT_GATE: Q3.1, Q4.3, R17.2
BAT_SENSE: Q3.3, R11.1
BOOST_FB: R7.2, R8.1, U7.3
BOOST_IN: C7.1, JP1.1, L1.1, Q1.3, U7.4, U7.5, U8.3
BOOST_RAW: C8.1, C9.1, D1.1, R7.1, TP12.1, U8.1
BOOST_SW: D1.2, L1.2, U7.1
EC_ADC: J1.1, R3.2, R4.1
EC_FILTERED: D2.1, J7.3, R4.2, TP9.1
GND: C1.2, C7.2, C8.2, C9.2, C10.2, C11.2, C12.2, C13.2, C14.2, C15.2, C16.2, C17.2, C18.2, D2.2, J2.6, J3.2, J4.2, J7.1, J9.1, Q2.2, Q4.2, R6.2, R8.2, R10.2, R12.2, R18.2, TP6.1, U1.1, U1.3, U1.6, U1.7, U7.2, U8.2
I2C_SCL: J1.6, R2.2, TP8.1, U1.10
I2C_SDA: J1.5, R1.2, TP7.1, U1.9
PH_DIV: C11.1, R9.2, R10.1, R15.1
PH_EN: J1.2, Q2.1, R6.1, TP11.1
PH_GATE: Q1.1, Q2.3, R5.2
PH_OUT: J9.3, R9.1, TP10.1
PH_SUPPLY: J9.2, JP1.2
VBAT: J4.1, J5.2, Q3.2, R17.1, TP2.1
VBAT_RAW: J3.1, J5.1, TP1.1
