toxonpf/aquaNode/(commit log)

2026-10-21 Expand buoy story, team interactions and ocean rendering
    - Expand the buoy story into five chapters: surface, close-up,
    underwater probes, internal electronics and buoy network
    - Add animated camera paths with desktop and mobile framing
    - Synchronize chapter text appearance with background shading
    - Widen story panels and align them with the site layout
    - Align the second chapter's content to the right
    - Add internal text scrolling before advancing to the next chapter
    - Hide text-panel scrollbars while preserving scrolling
    - Remove excessive scroll gaps between chapters
    - Prevent wheel momentum and repeated input from skipping chapters
    - Support chapter navigation through links, keyboard a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
2026-10-22 Refine ocean story navigation, transitions and team interactions
    - Improve story chapter navigation and prevent accidental chapter skipping
    - Handle wheel momentum, repeated input, touch gestures and keyboard controls
    - Add internal text scrolling before allowing navigation to the next chapter
    - Synchronize chapter progress, indicators, scroll hints and panel transitions
    - Refine mobile and desktop layouts for story panels and chapter content
    - Improve page transitions with loading states and destination scene readiness
    - Handle rapid navigation, browser Back navigation and transition failures
    - Preserve reduced-motion behavior and static fallback rendering
    - Refine the ocean scene with upd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
2026-10-23 feat: redesign Build and improve site readability
    - Increase text sizes and improve caption contrast
    - Add engineering drawings, assembly steps, and resource downloads
    - Animate step expansion and fix anchor navigation
    - Fix team profile dimensions and transitions
    - Verify responsive layouts and add regression tests
2026-10-24 feat: prepare AquaNode for public deployment
    - refine ocean, buoy, and underwater scenes with new animations
    - improve page transitions and the loading screen
    - add responsive header, footer, language switching, and custom cursor
    - refresh the Home, About, Technology, Build, Journal, and Team pages
    - add team photos, animated profiles, and contact layouts
    - reorganize models, images, fonts, and resources into structured folders
    - translate the website interface into Russian
    - improve interactive arrows, buttons, download icons, and external-link icons
    - add smooth scrolling, responsive typography, and two-line heading limits
    - configure SPA redirects for Cloudflare Pages
    - add browser tests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
2026-10-28 feat: add observation atlas and redesign responsive site sections
    - Add clustered buoy maps, station archives and labelled demo readings
    - Embed map previews and enable wheel zoom in fullscreen mode
    - Rework mobile learning, drawings, journal and assembly sections
    - Add an interactive circuit diagram with sequential mobile explanations
    - Animate the mobile menu and preserve it during page transitions
    - Fit member profiles within the viewport and improve portrait crops
    - Refine ocean layouts, scrolling, downloads and footer navigation
    - Replace section numbering with 33 thematic SVG icons
    - Add regression tests and update documentation
    [stations_data_en.csv]
2026-10-29 feat: add Taiwan localization and refine site UI
    - Add Traditional Chinese (zh-TW) with live language switching
    - Introduce a language dropdown with clear hover feedback
    - Redraw EC-revB architecture illustrations for desktop and mobile
    - Redesign the preparation section with responsive component cards
    - Simplify the header progress link and architecture download button
    - Use the original logo waves as the site favicon
    [AquaNode-B_Cu.gbl, AquaNode-B_Mask.gbs, AquaNode-Edge_Cuts.gm1, AquaNode-F_Cu.gtl, AquaNode-F_Mask.gts, AquaNode-F_Silkscreen.gto, AquaNode-job.gbrjob, AquaNode.drl]
2026-11-02 feat: update project to EC+pH revC and refresh team profiles
    - Update project information and status to revC
    - Add the isolated pH channel to the buoy scenes and architecture
    - Refresh localized diagrams, documentation and public resources
    - Add Ayan's portrait and rename team photos consistently
    - Add social links for team members
    - Change Ayan's role from Sponsor to Helper
    - Update localization and checks
    [AquaNode.kicad_pcb, AquaNode.kicad_sch, BOM.csv, results_blank.csv]
2026-11-06 feat: update deployment information, redesign station archive and animate language changes
    - Add OCA, HPU and Aktau School No. 15 collaboration details
    - Show simulated Taiwan deviation averages by quarter
    - Redesign the station archive for desktop and mobile
    - Animate text exit and entrance when switching languages
    - Preserve map state, selected station and observation period
    - Update translations, documentation and regression tests
2026-11-07 fix: stabilize language transitions and set buoy cost to $20
    - Animate layout dimensions before revealing translated text
    - Keep line breaks stable throughout the text entrance
    - Prevent text flashes and animate missing labels
    - Align the revC test-plan paragraph
    - Display the buoy cost as $20 USD
    - Add frame-by-frame transition regression checks
